Oumniaa/BHIKIRprojet_robot_pompier/code/Precision.md

Nous rappelons que notre projet est un robot pompier roulant sur des chenilles avec un bras robotique capable d'ouvrir des portes pour éviter les explosions de fumées aux soldats de feu, ainsi notre dépot est organisé comme suit :
 
 - Un fichier dédié au bras robotque contenant les 2 codes source faisant bouger le bras (servomotors).
 - Un fichier caméra.ino pour le fonctionnement du module cameraVga.
 - Un fichier moteur contenat la totalité des classes organisant la réception de la consigne (position) à travers les capteurs (laser,distance,module arduCam), le controles des moteurs (motor CC). ainsi qu'un fichier Jetson nano contenant la totalité des commandes utilisées.

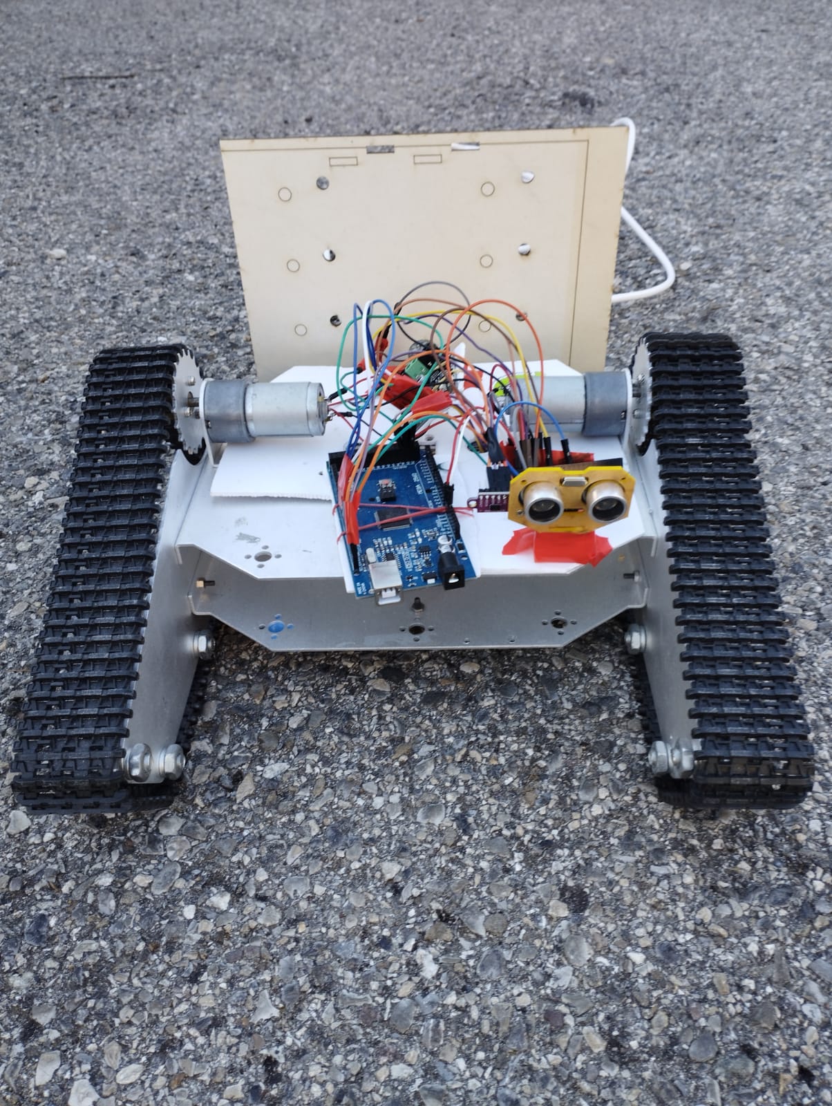
[picture p1: code/robot.jpg]
Photo Robot
  .

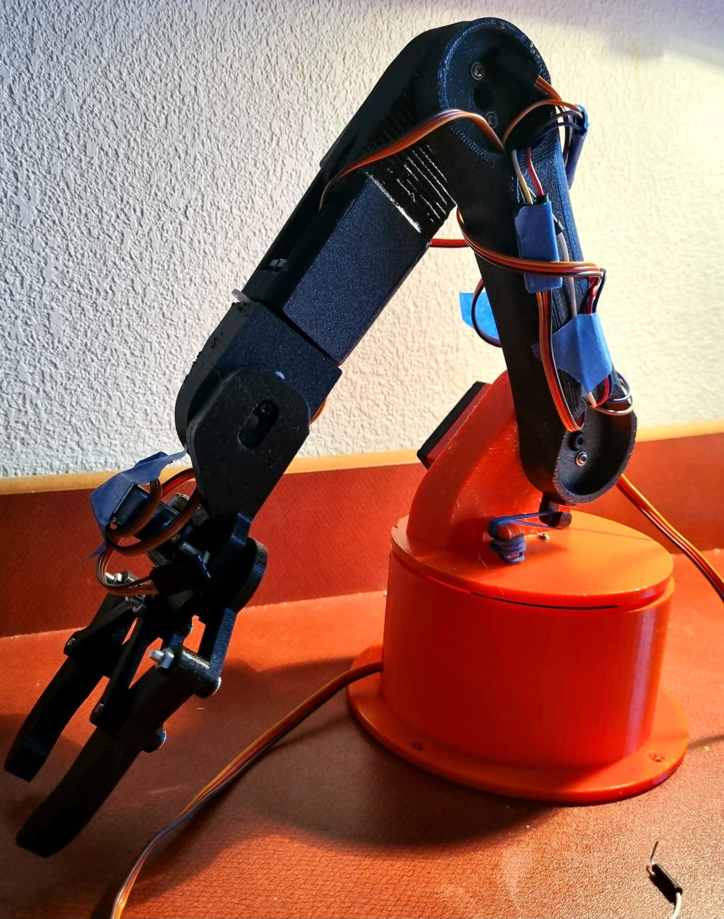
[picture p2: code/bras.jpg]
Photo bras
  .
