Oumniaa/BHIKIRprojet_robot_pompier/CompteRenduSeance/rio-rapport-seance-6.pdf

Guillaume RIO
Compte rendu 6ème séance
Comme nous avons dû rendre les cartes nvidia donc je vais durant cette séance réaliser une fonction afin d’éviter les obstacles.
Ensuite je vais coupler notre capteur de distance (ultrasons) avec un capteur de distance laser.
Je lui ai réalisé une classe dédiée.
Ensuite j’ai commencé à remplacer notre carte qui contrôle les moteurs par une nouvelle.

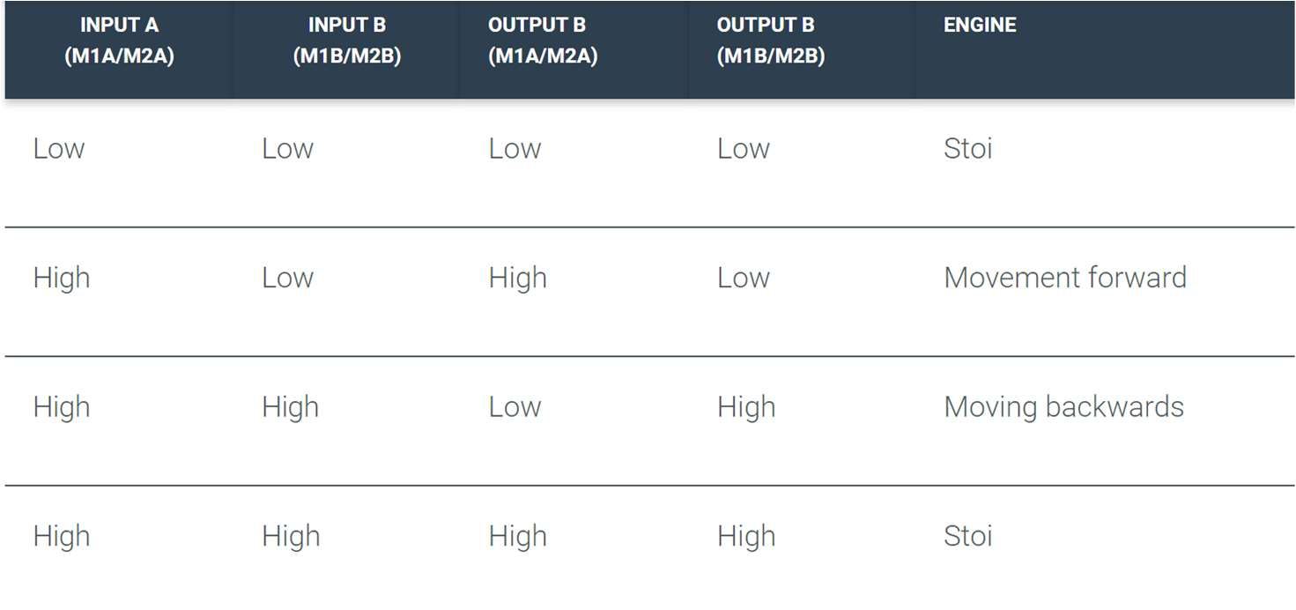
[picture p18: figure]

Donc après avoir réalisé les branchements, j’ai fait fonctionner les moteurs à la main (avec les boutons intégrés à la carte)
Puis j’ai fait fonctionner les moteurs avec un programme simple

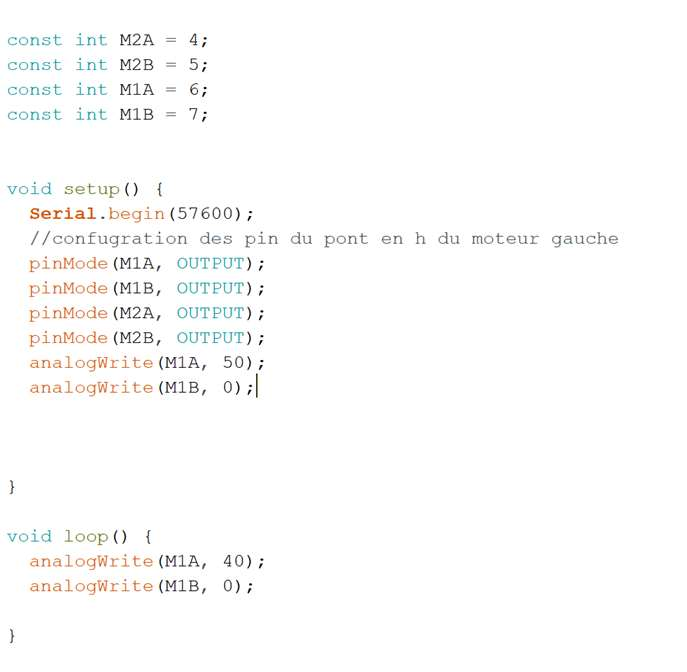
[picture p19: figure]

J’ai ensuite programmé une classe afin de gérer les moteurs avec ce nouveau controller. Afin de pouvoir avancer, reculer, tourner à droite, tourner à gauche (sur lui-même). Enfin j’ai découpé une plaque de plastique afin d’éviter les cours circuits lorsque les composants sont posés sur la plaque d’aluminium.
