Oumniaa/BHIKIRprojet_robot_pompier/CompteRenduSeance/rio-rapport-seance-3.pdf

RIO Guillaume

### Rapport séance 3

Tout d’abord, j’ai fait tourner les moteurs sans les controlers. En les alimentant directement.
Une fois cette étape réaliser j’ai récupéré un pont en h afin de pouvoir connecter et controller les deux moteurs. Une fois la connectique effectué, j’ai modifié ma structure moteur afin que chaque moteur est son pin de contrôle de la vitesse et les deux pin de contrôles du sens de rotation stocké.

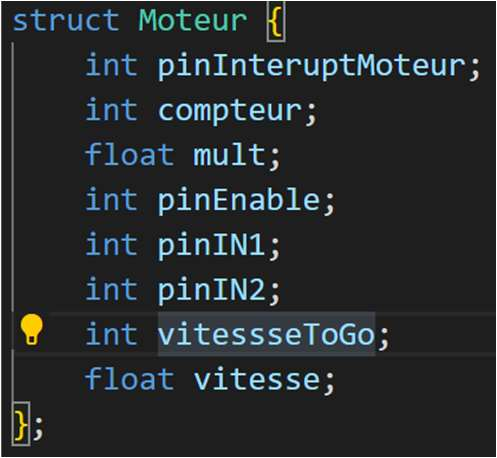
[picture p20: figure]

Ensuite, j’ai ajouté des fonction afin de controller le sens de rotation (avancer, reculer, tourner à gauche, tourner à droite)

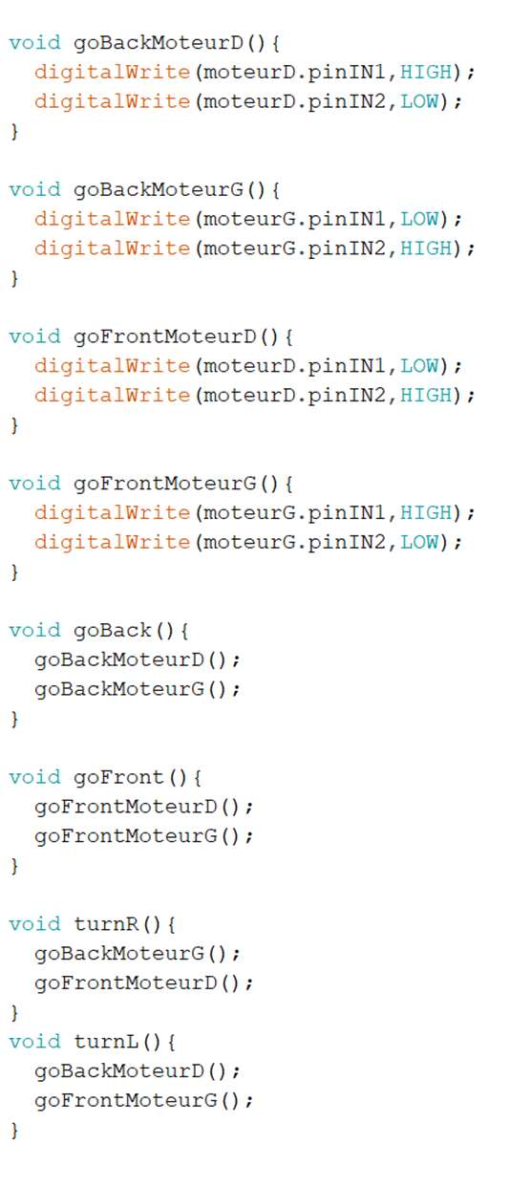
[picture p21: figure]

Ensuite, j’ai réaliser les fonctions afin de géré la vitesse. (stop et avancer)

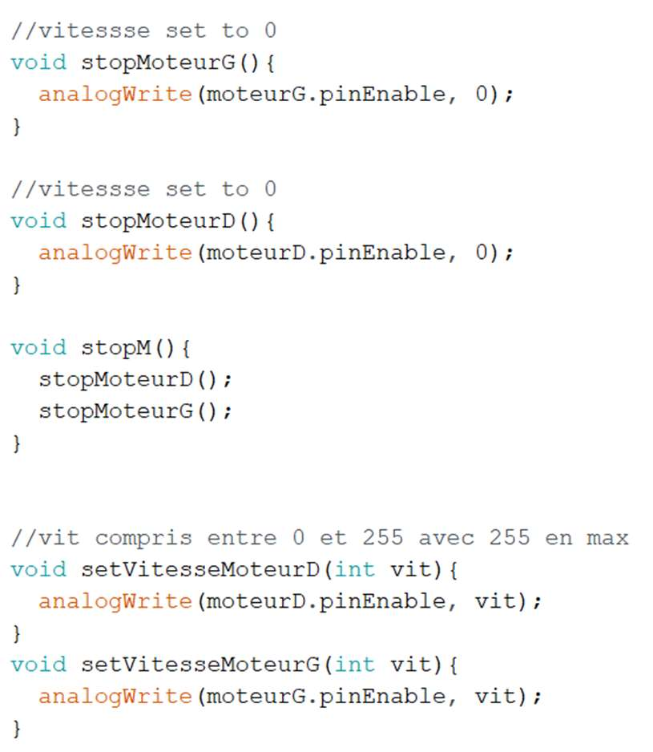
[picture p22: figure]

Enfin j’ai cablé le capteur de distance et j’ai inplémenté la classe du capteur de distance afin que le robot avance et lorsque le capteur de distance détecte un obstacle à moins de 10cm le robot s’arrète .

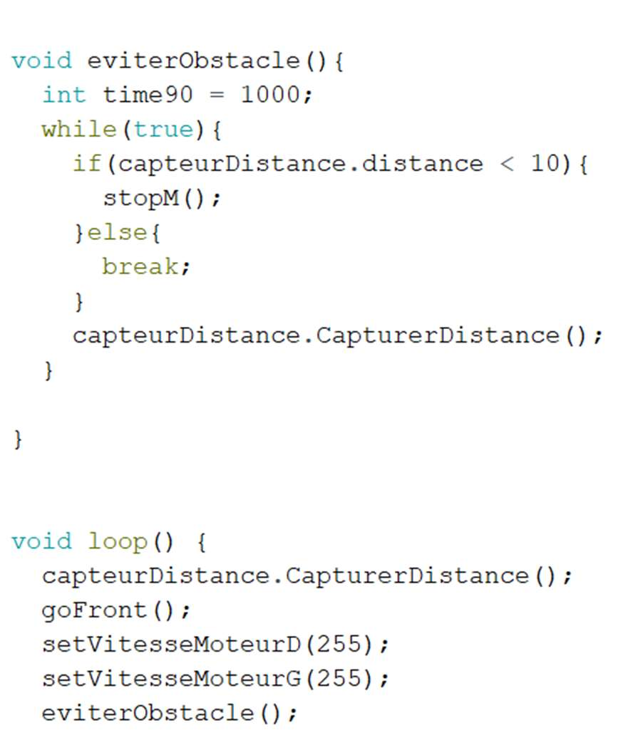
[picture p23: figure]
