Oumniaa/BHIKIRprojet_robot_pompier/CompteRenduSeance/rio-rapport-seance-2.pdf

RIO Guillaume

### Rapport séance 2

Mr Massons nous a été proposé de directement utiliser les chenilles d’un châssis d’un robot déjà constitué et avec des moteurs. Le problème est que les moteurs n’ont pas d’encoder permettant de récupérer notre vitesse. J’ai donc recherche s’il existe ce même moteur mais avec un encoder. Je n’ai rien trouvé de satisfaisant, je vais donc pour le moment ignorer cette manière de calculer la vitesse et on tentera de se débrouiller avec nos capteurs de distance et notre caméra.
J’avais comme première idée de faire une structure qui contiendra les paramètres de mon moteur et une classe de gestion des moteurs qui réalisera les fonctions lié au moteur. J’ai donc réaliser ceci : La structure :

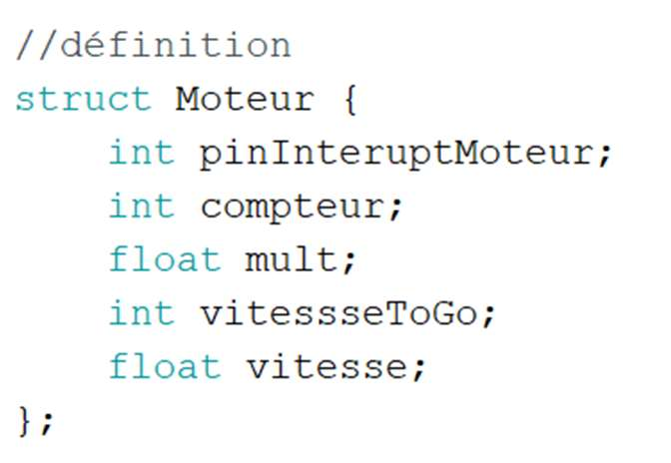
[picture p24: figure]

La classe :

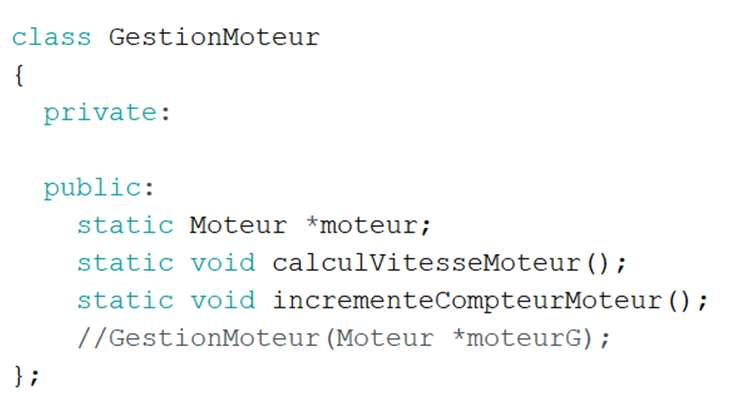
[picture p25: figure]

Les méthode et initialisation :

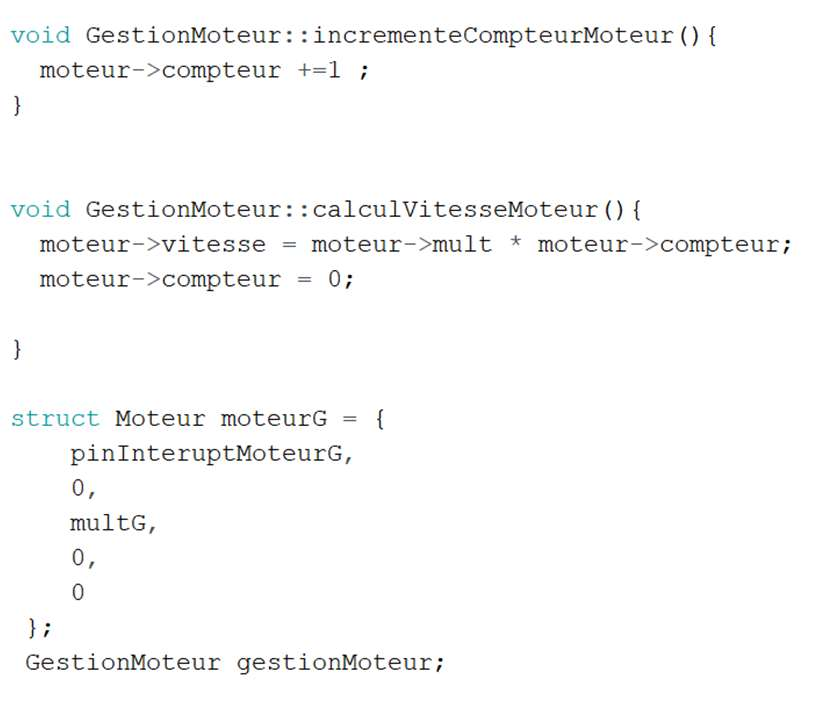
[picture p26: figure]
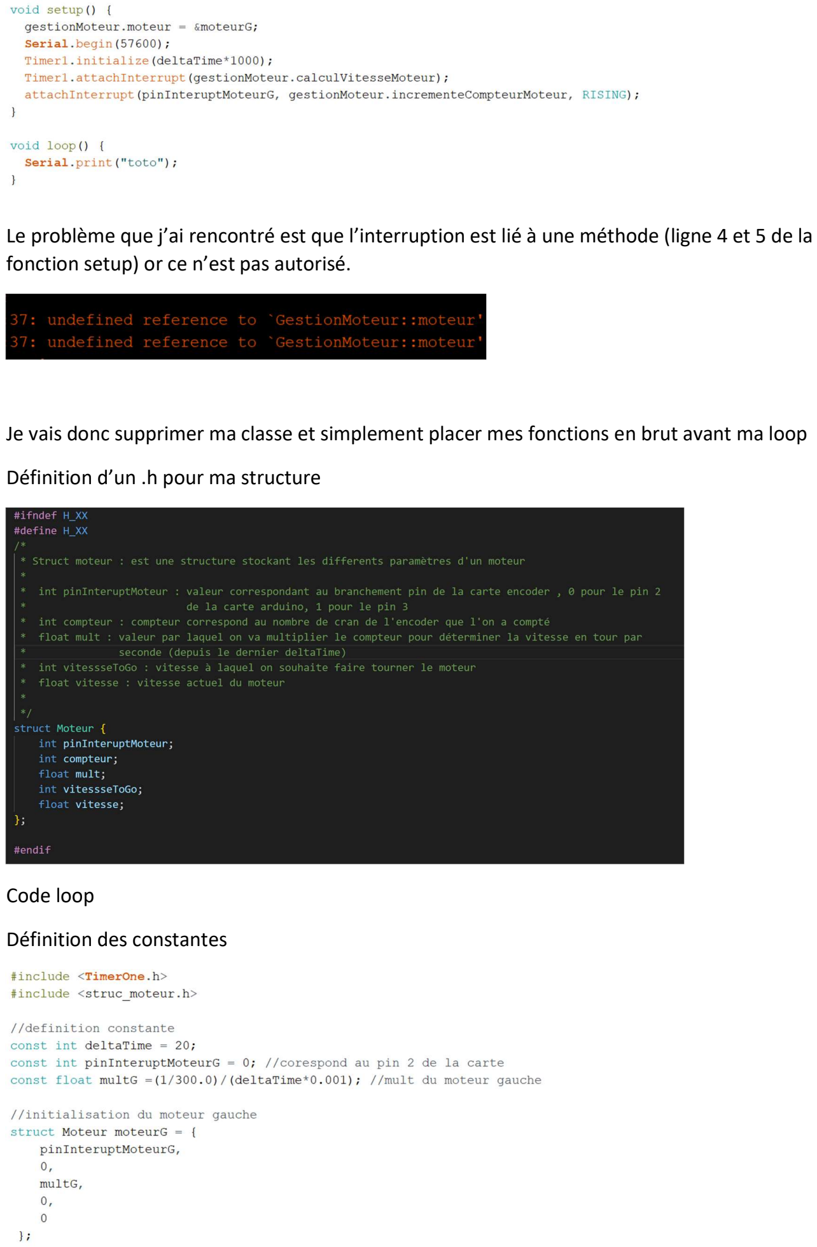
[picture p27: page 2]

Le problème que j’ai rencontré est que l’interruption est lié à une méthode (ligne 4 et 5 de la fonction setup) or ce n’est pas autorisé.

Je vais donc supprimer ma classe et simplement placer mes fonctions en brut avant ma loop Définition d’un .h pour ma structure

Code loop
Définition des constantes

Définition des fonctions pour les interruptions du moteur

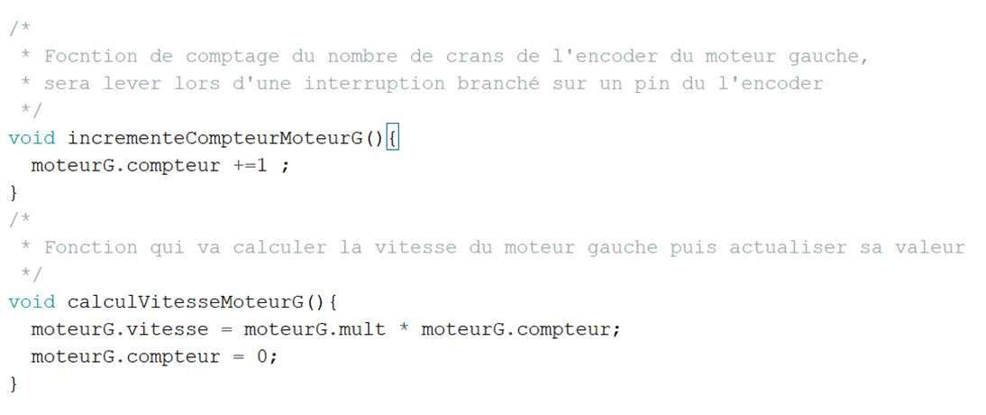
[picture p28: figure]

Définition du setup et loop

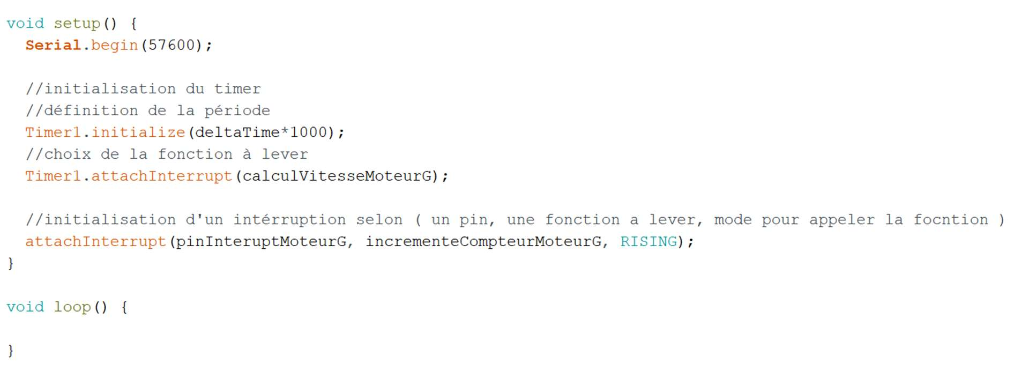
[picture p29: figure]
