Oumniaa/BHIKIRprojet_robot_pompier/CompteRenduSeance/Session 12-BHIKIR.pdf

Session 12

180° servomotors are now controlled with the PCA9685 module.

In order to be able to calculate the angles of movement of the arm from the known position of the object. We will use Al-Kashi's theorem (fig1), the position to be reached will correspond to the centre of the object that equal the centre of the arm gripper.

At first, we will simplify the case study to an arm with 2 mobile segments (we ignore the rotating base and the arm-clamp connection), then we will go to 3 segments and so on.

We retrieve the dimensions of the arm:

r1 = the humerus = piece connected to the first servomotor = 165 mm.

r2 = The ulna = piece connected to the second servomotor = 110 mm.

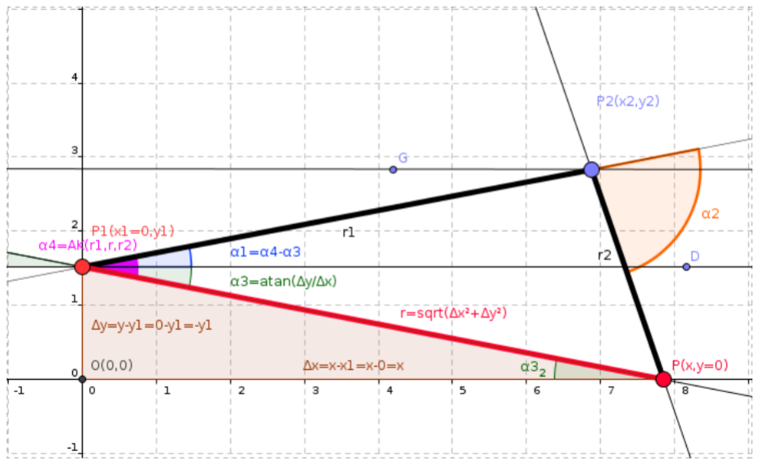
[picture p39: figure]

Fig 1: Al Kashi's theorem used to calculate the value of the 2 angles of the 2 servomotors of a 2-axis motorized arm.

The arm is positioned by giving (x, y) coordinate, and via what I understood from the concept of inverse kinematics [1], this is translated to the required servo angles.

The code is composed of two main functions:

1. Movearm (fig 2) responsible for the movement of the arm, we put the coordinates of the point to reach as a parameter then we calculate: angleE = alpha4 (fig1), angleS = alpha2.
2. MoveServo (fig 3) to adjust the measurements, since the Arduino has a margin of error.

The measurements are then transformed from radians to degrees.

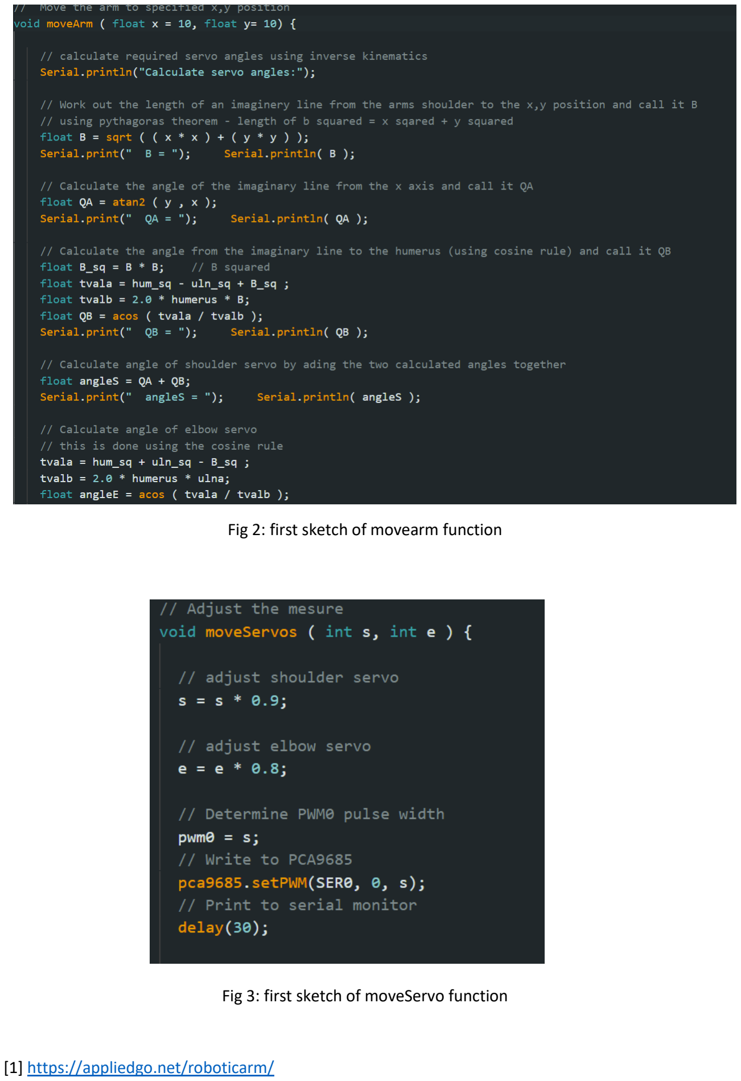
[picture p40: page 2]

Fig 2: first sketch of movearm function

Fig 3: first sketch of moveServo function

[1] https://appliedgo.net/roboticarm/
