Oumniaa/BHIKIRprojet_robot_pompier/CompteRenduSeance/Session 10-BHIKIR.pdf

Session 10

During this session, which served as a presentation of the end of the accomplishments during the 1st semester, I mounted the last missing part of the arm, the clamp. A model that I took from Grabcad – robot adaptive clamp- [1]. I then only modeled the arm-gripper connection.

This done, I mounted the parts together, and ensure that the 3 servomotors of the waist- and elbow base are powered at 6v with an external power supply and a DC DC converter while the other 3 servos are linked to 5V provided by the Arduino Uno.

The design part being finished (fig1), we now move on to the code.

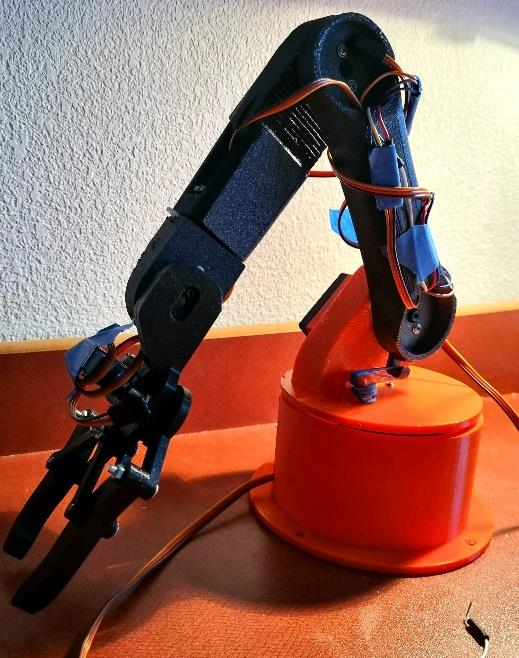
[picture p41: figure]

Fig 1: complete assembly of the robotic arm

First of all, the servos worked with potentiometers, one potentiometer per servo telling it the angle it has to go (fig2).

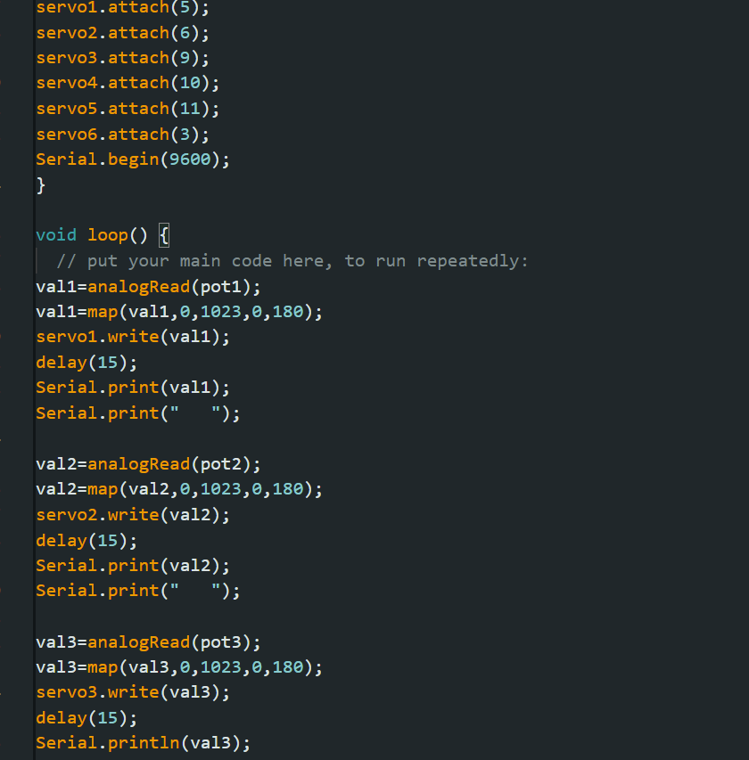
[picture p42: figure]

Fig 2: Knob code to control a servo with a potentiometer

The arm is now functional, I am now trying to order it with a Bluetooth module, first I establish the connection between the HC -05 module and my smartphone (fig 3) by following the technical sheet provided Go tonic [2]. However, two-way communication is not established, the transmission is successful, however I do not receive the reception message

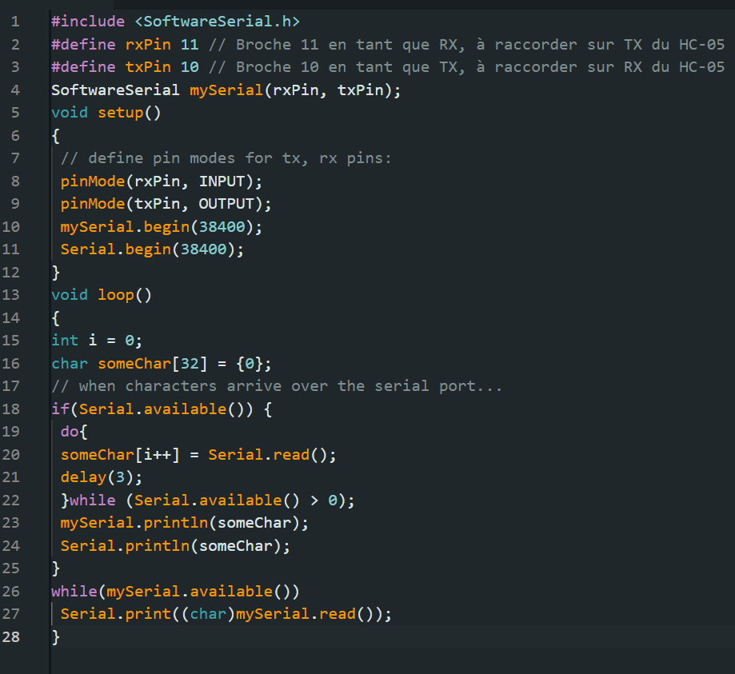
[picture p43: figure]

Fig 3: HC-05 / smartphone pairing code

[1] https://grabcad.com/library/tag/pince
[2] https://www.gotronic.fr/pj2-guide-de-mise-en-marche-du-module-bluetooth-hc-1546.pdf
