Oumniaa/BHIKIRprojet_robot_pompier/CompteRenduSeance/Session 9-BHIKIR.pdf

Session 9

I started by defining the list of handles that our arm can open crutch handle, button handle, L key handle.

Initially omits the pull handles which would require a torque exceeding that of our current servomotors as well as a backward movement.

Done, I start modeling the pliers by refining the tips to be able to grab the handle as well as possible, the impression will be launched at the next session.

In parallel, to set up an optimized code, I continue by defining the limits of movement of my angles, the mapping of the motors produced, I resume writing the code.

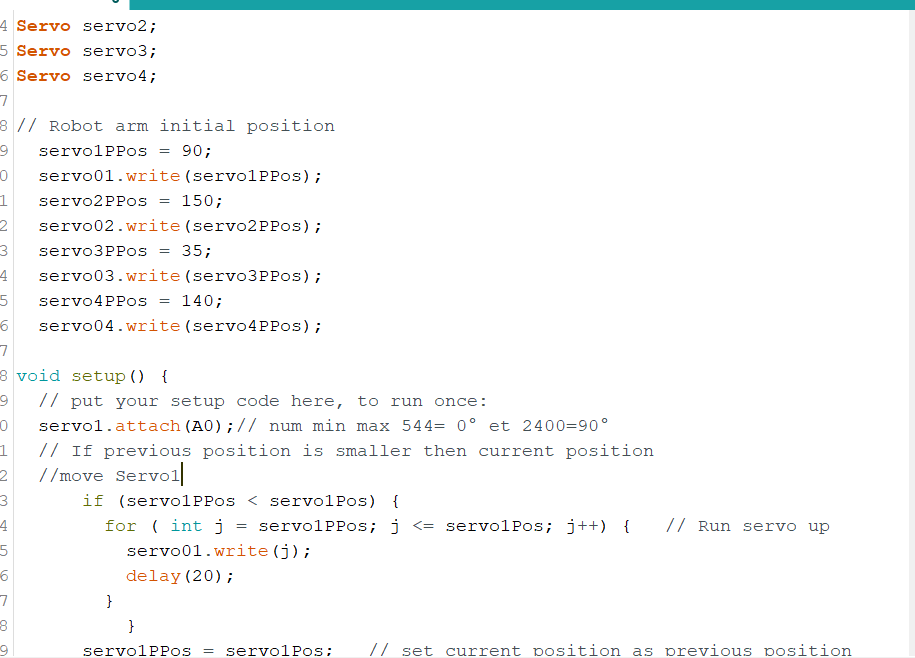
[picture p46: figure]

Fig 1s Code’s sketch

First, the code will be written without class then test to debug then a Servomotors class will be defined with functions like: StartMotor, RotateRight, RotateLeft …

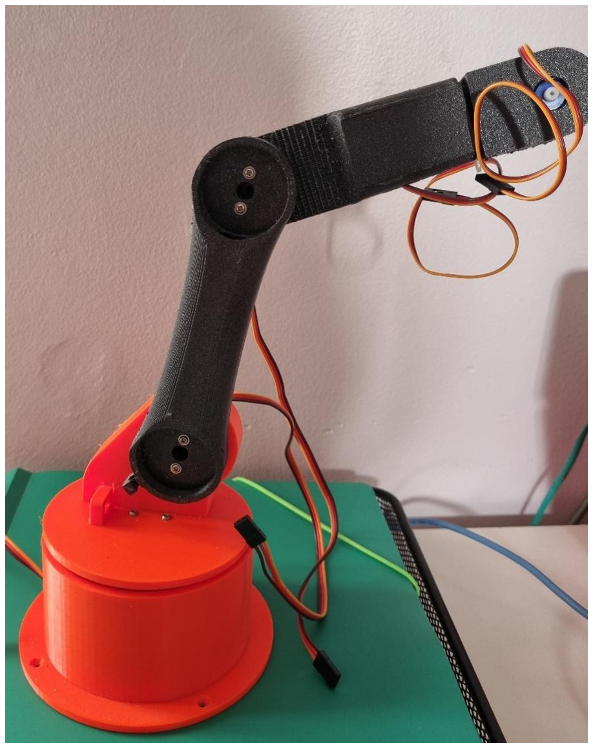
[picture p47: figure]

Fig 2 : First arm look
