Oumniaa/BHIKIRprojet_robot_pompier/CompteRenduSeance/Session 5-BHIKIR.pdf

Session 5

During this session I tried to give the robot its final look.

I started by dismantling the tank to recover the pair of tracks. thing done I materialized the wooden plates leaving spaces to integrate the motors and a certain number of holes to target the digital cards.

the laser cutter broke down during the first hour I resumed my work on the robotic arm, unfortunately the base of my arm is 20 cm in diameter the plate of the Prusa printer is 15cm which pushes me to reduce the size of my base and risk impacting the stability of my arm or printing on the volumic.

I opt for the second option in a first place at the risk of having to resize everything. In the meantime, the 2 servomotors acquired during the previous sessions are functional (the class is finalized), their real effectiveness will be measured during their integration into the arm.

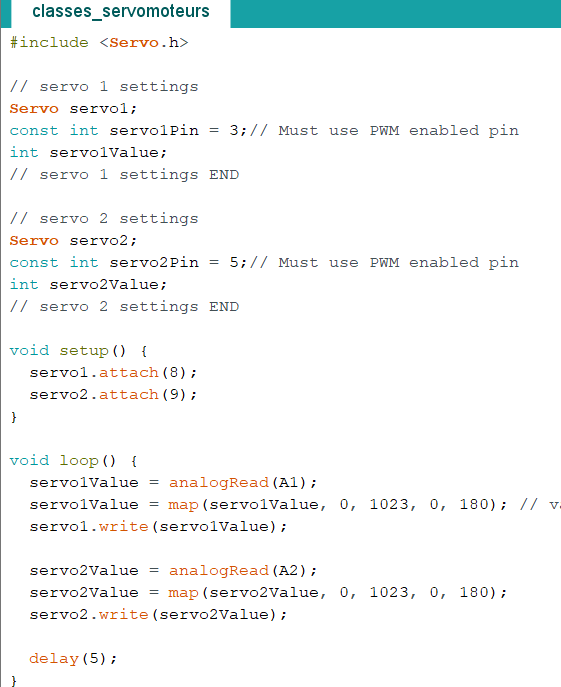
[picture p53: figure]

the laser cutter finally functional with plywood I cut the first boards (lower and side) by binding them with a wedge. the result is functional but gives an effect "tinkered not clean". So not satisfied I direct my choice towards a parametric box with notches that can be linked without wedges (to be glued potentially).

The raw model is available on boxes.py : https://www.festi.info/boxes.py/UniversalBox?language=fras

I have already determined the entry of the DC motors and the location of the screws; they just have to add them now on insckape.
