Oumniaa/BHIKIRprojet_robot_pompier/CompteRenduSeance/Session 1 ang.pdf

### Session 1

1. Chassis and hull design.

The first part of the session was dedicated to the search for the crawlers that best suited the structure of the imagined robot, after many counting, we decided to start on the model Trex 355*265*130 mm, which allowed to obtain a certain exploitable volume.

The track system will be recovered and we will inject our own DC motor.

https://www.gotronic.fr/art-chassis-a-chenilles-t-rex-21385.htm

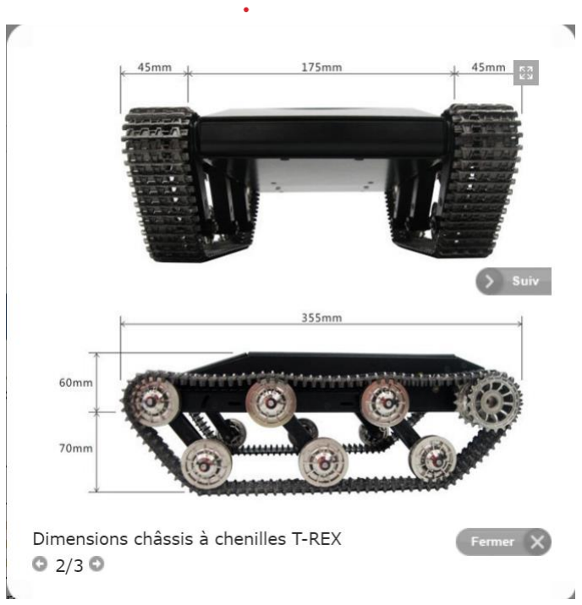
[picture p61: figure]

Once the measurement were established, the first sketch of the hull was made.

It was necessary to determine the most optimal location of the components inside the hull (a wooden cube 175*350*70), the rest of the height is left to the retractable arm.

2. Arrangement of the components within the shell.

The 6 wooden boards will be connected by screwed gaps otherwise the ventilation nestled on the back will be neglected at first.

- Top board: the arm will be connected to the rest of the structure by a circular system of 8 holes.
- Back board: the battery whose mass estimated at 70g will be glued to the middle of the rear board.
- Front board: a 3mm plexiglass plate will be plated to the front board, through this plate the camera supported by a modeled support to create the next session, the ultrasound sensor and infrared detector will be able to work.

- Bottom board: will contain the rest of the electronic components (accelerometer/gyroscope/Arduino board screwed in the middle, Nvidia card connected initially to the camera) by adding holes to connect all the actuators and electronics, which will be glued with hot glue or tape).

Once all the components delivered, we will make sure of the measurements again before cutting the frame in the final material ( wood ).

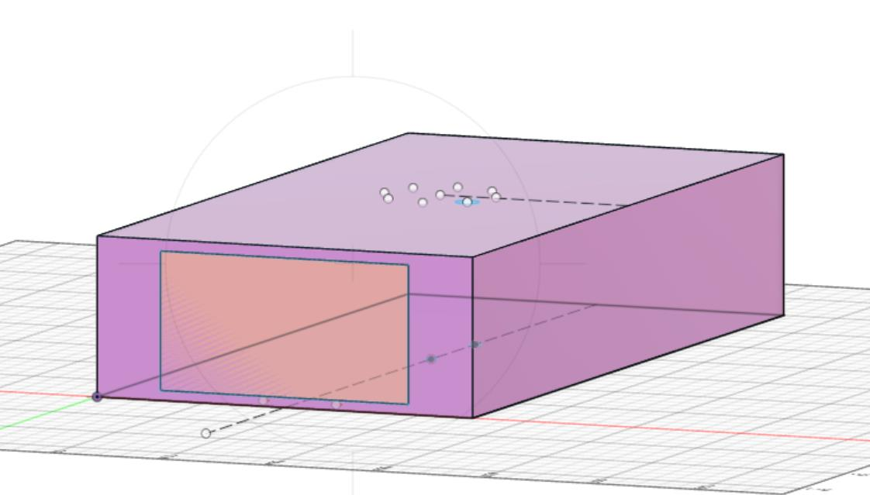
[picture p62: figure]

Once the chassis / shell part is finished, I’ve been interested in operating the HC-SR04 ultrasound sensor that will be glued to the bottom board back of the plexiglass plate.

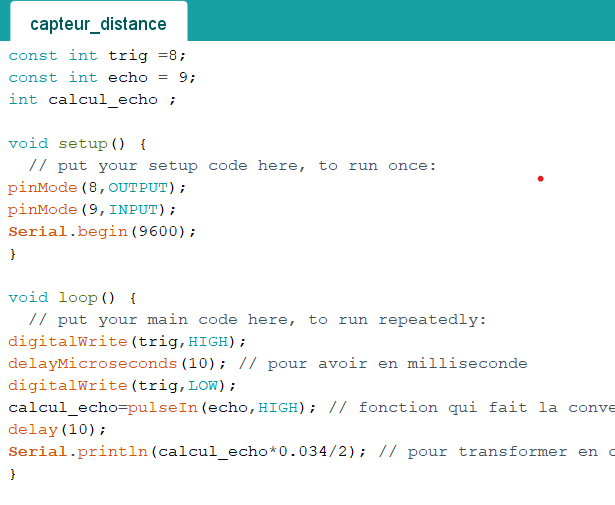
[picture p63: figure]

Well, the sensor works, I can now define a SensorDistance class that can be called anytime during the program to display the speed.

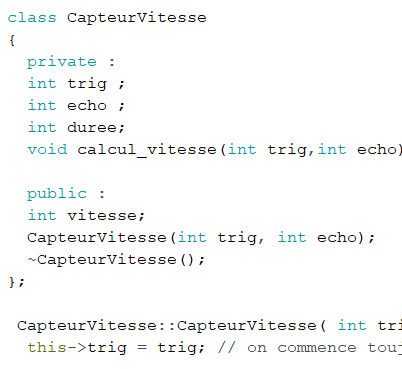
[picture p64: figure]
