Oumniaa/BHIKIRprojet_robot_pompier/CompteRenduSeance/rio-rapport-seance-21.pdf

Guillaume RIO
Compte rendu 21ème séance
- Fixage mécanique des composants du robot
- Réalisation du câble managent
- Réalisation de test sur le bras
