Oumniaa/BHIKIRprojet_robot_pompier/CompteRenduSeance/rio-rapport-seance-20.pdf

Guillaume RIO
Compte rendu 20ème séance
- Corriger des problèmes de rotation du robot
- Ajout d’une nouvelle couche pour la détection de la porte (avec la couleur)
- Aide à oumnia la détection de la poigné
- Réalisation de test sur le robot
