Oumniaa/BHIKIRprojet_robot_pompier/CompteRenduSeance/rio-rapport-seance-18.pdf

Guillaume RIO
Compte rendu 18ème séance
- Bombé la porte en orange pour mieux la reconnaitre dans l’environnement
- Optimisation de la stratégie pour aller vers la porte
- Explication à Oumnia comment faire de la détection d’image
- Fixation du bras sur le robot
