Oumniaa/BHIKIRprojet_robot_pompier/CompteRenduSeance/rio-rapport-seance-15.pdf

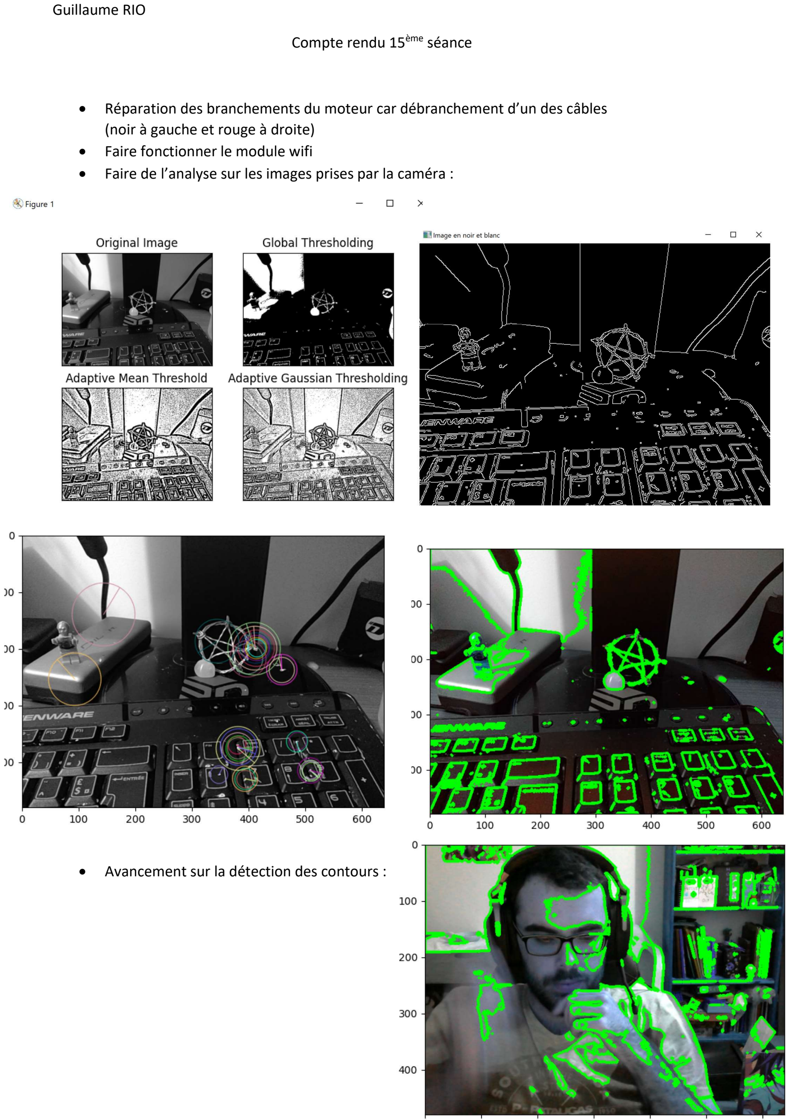
[picture p65: page 1]

Guillaume RIO
Compte rendu 15ème séance
- Réparation des branchements du moteur car débranchement d’un des câbles (noir à gauche et rouge à droite)
- Faire fonctionner le module wifi
- Faire de l’analyse sur les images prises par la caméra :

T

- Avancement sur la détection des contours :

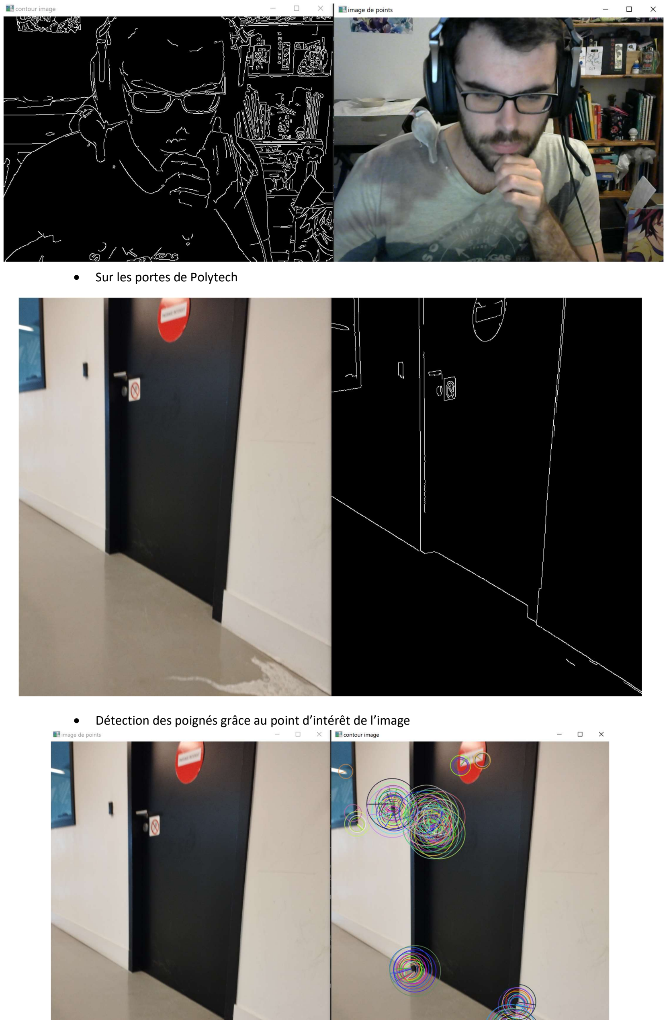
[picture p66: page 2]

- Sur les portes de Polytech
- Détection des poignés grâce au point d’intérêt de l’image

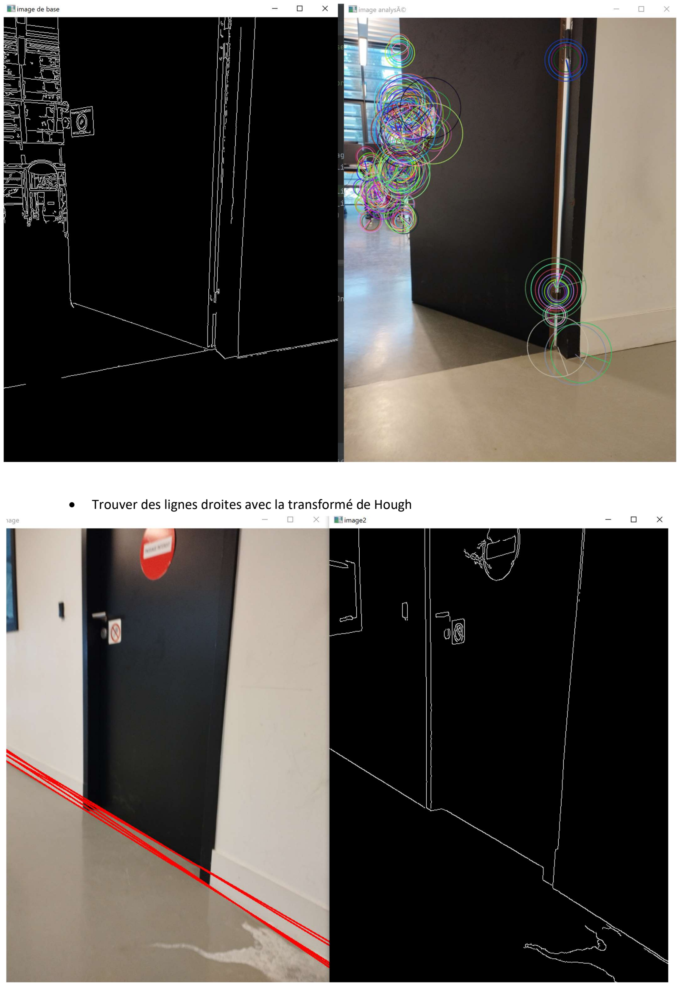
[picture p67: page 3]

- Trouver des lignes droites avec la transformé de Hough

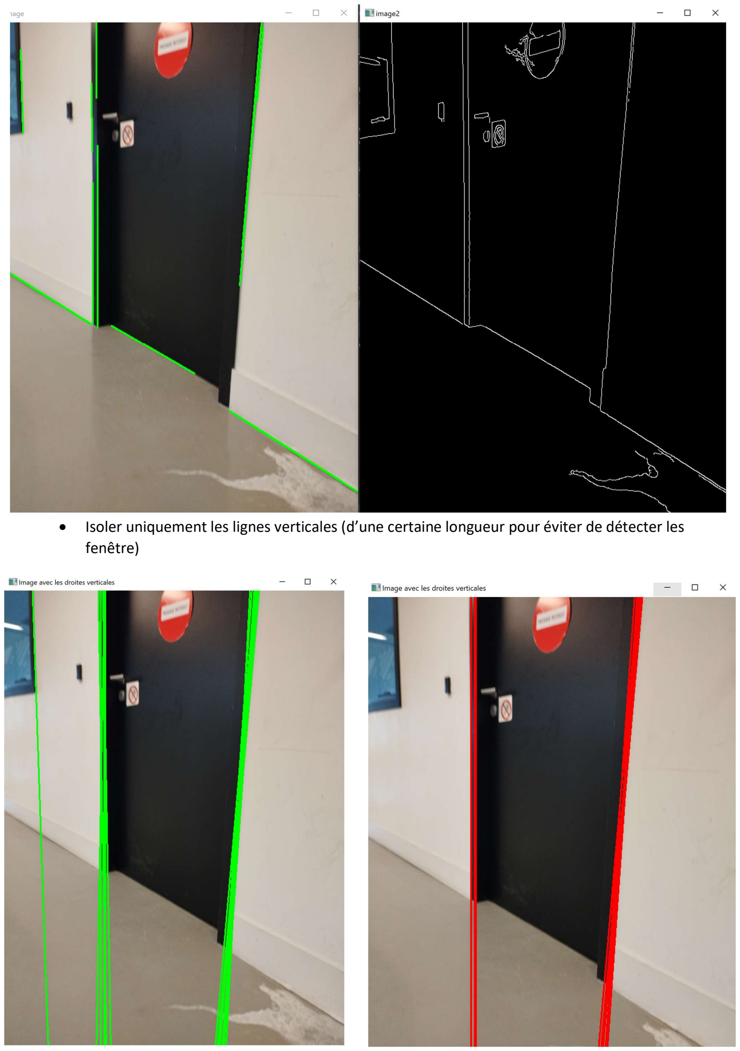
[picture p68: page 4]

- Isoler uniquement les lignes verticales (d’une certaine longueur pour éviter de détecter les fenêtre)

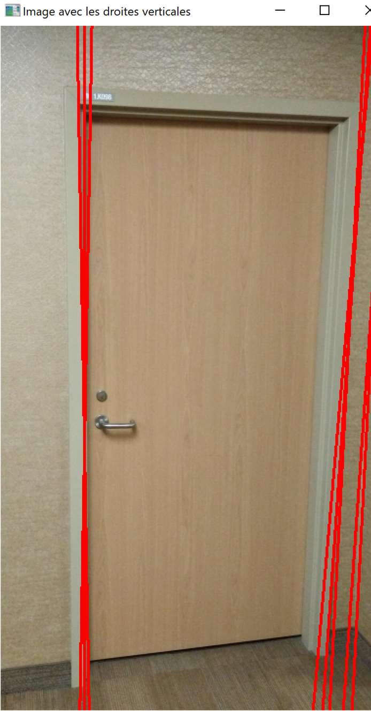
[picture p69: figure]
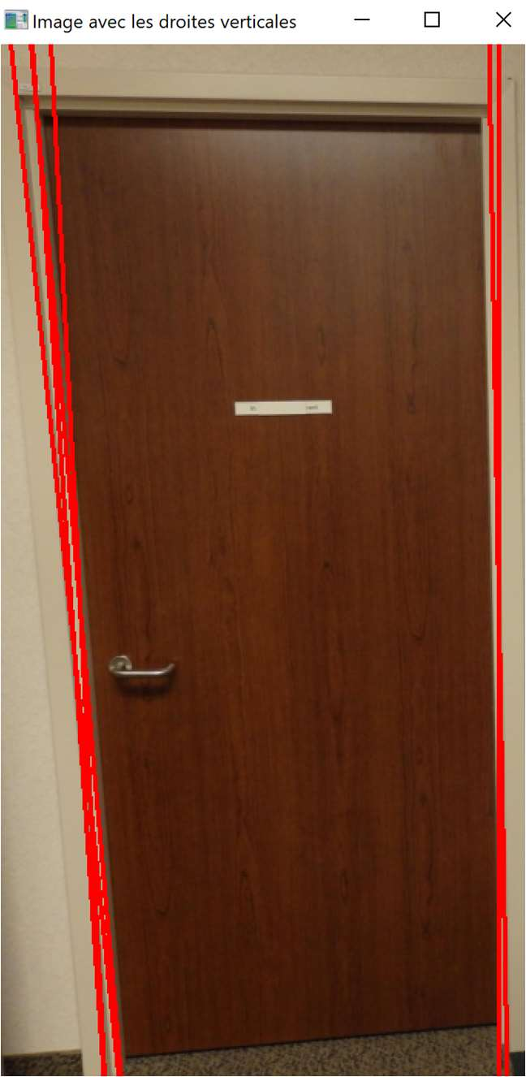
[picture p70: figure]

- Fabrication de la porte que l’on devra ouvrir
- Test d’ouverture par poussé avec le robot
