Oumniaa/BHIKIRprojet_robot_pompier/CompteRenduSeance/rio-rapport-seance-14.pdf

Guillaume RIO
Compte rendu 14ème séance
- Faire des tests sur l’IA entrainé sur 50 epoch
o J’ai observé que l’IA pensait que toute les images étaient des portes o J’ai donc ajouté des données au dossier nonPorte
- Utilisation de la caméra sur la carte
- Prise d’une photo et sauvegarde
- Utilisation de l’IA sur les images sauvegardées pour déterminer si on est fasse à une porte

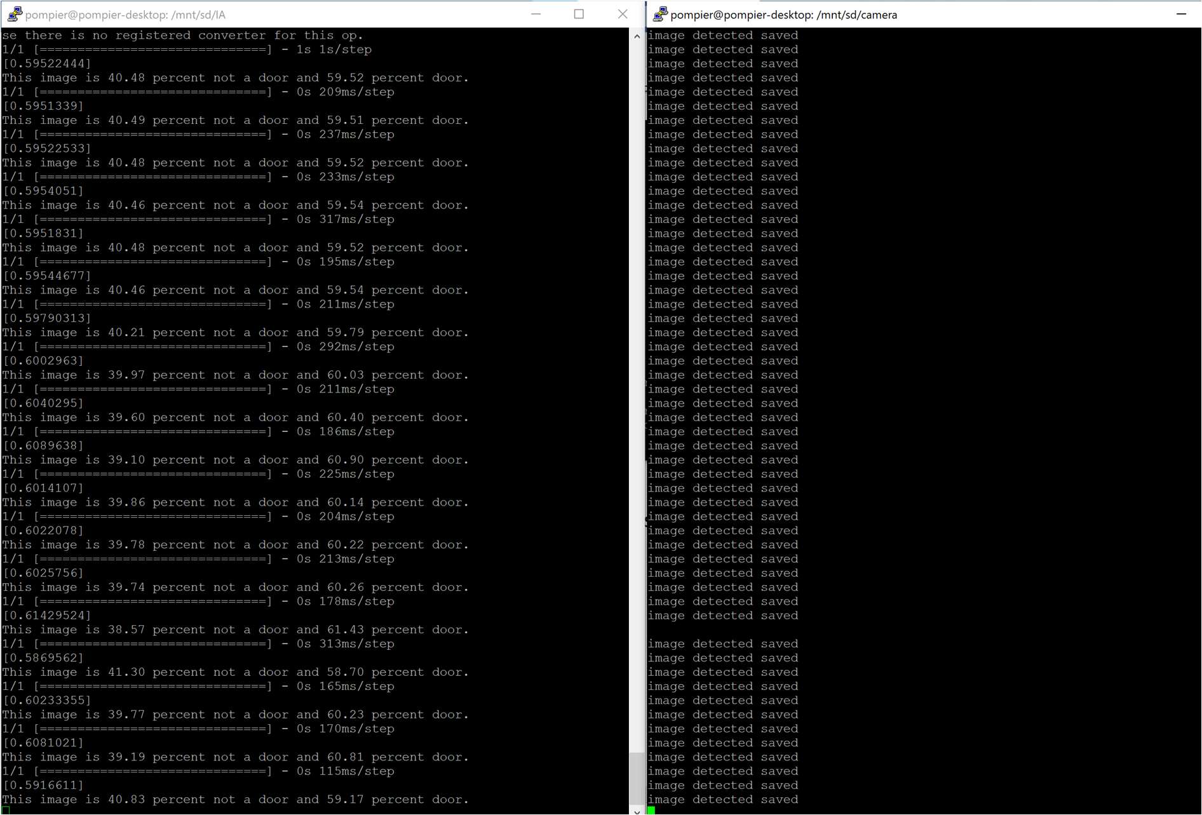
[picture p71: figure]

- Enfin j’ai commencé à lire de la documentation sur le module wifi
