Oumniaa/BHIKIRprojet_robot_pompier/CompteRenduSeance/rio-rapport-seance-12.pdf

Guillaume RIO
Compte rendu 12ème séance
- Sur mon IA qui commence à reconnaitre des portes :
o J’ai tout d’abord ajouté une fonctionnalité permettant de sauvegarder et de charger mon IA
o Problème d’installation de python sur la carte Nvidia, j’ai donc corrigé le problème
o Ensuite j’ai lancé des entrainements :

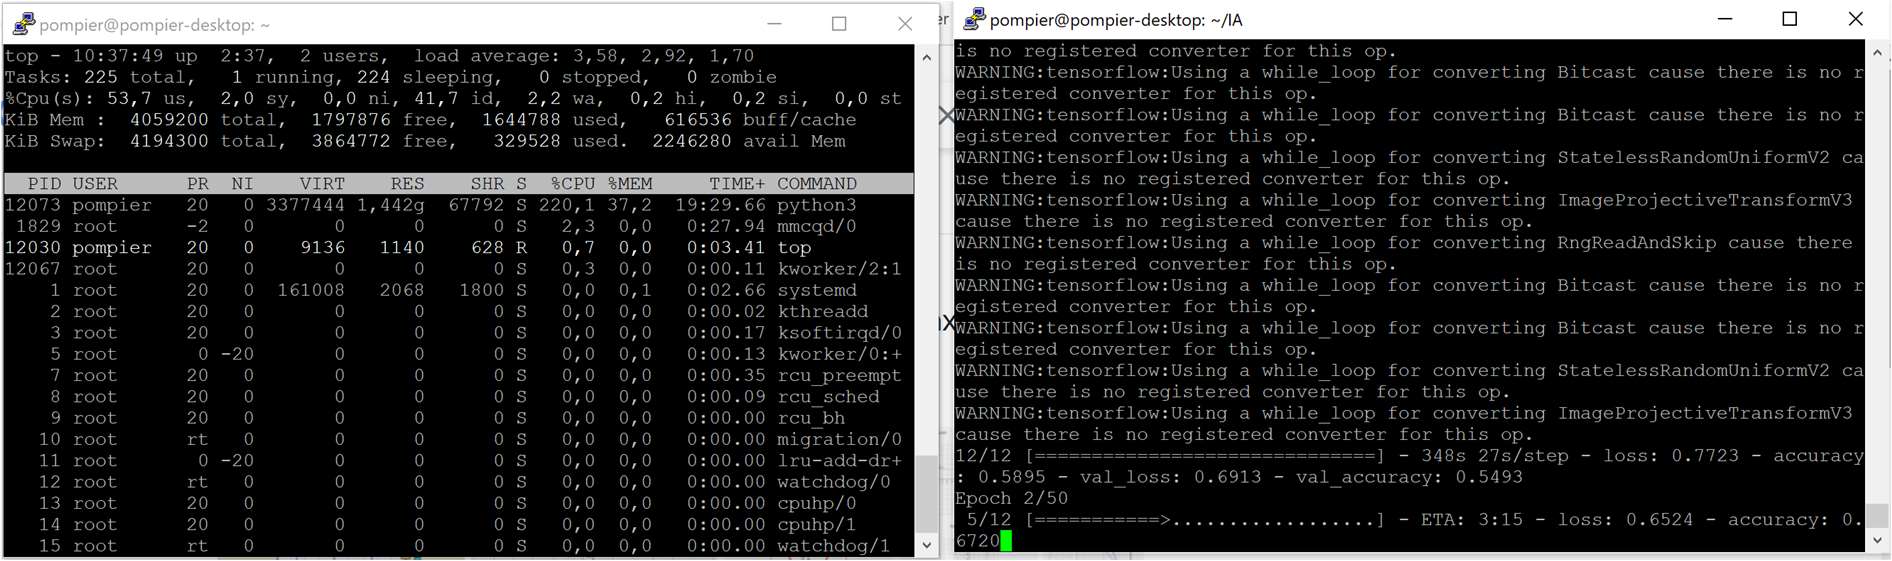
[picture p72: figure]

o Ensuite j’ai aidé Eva pour essayer d’avoir un truc fonctionnel
