Oumniaa/BHIKIRprojet_robot_pompier/CompteRenduSeance/rio-rapport-seance-11.pdf

Guillaume RIO
Compte rendu 11ème séance
- Recherche d’une base de données de porte
- Téléchargement de 4000 images puis je les ai triées une à une dans différents dossier (porte
(2) / escalier (0) / autre (1) )
- Réalisation d’une IA avec Keras sur le jeu de données téléchargées
o 1 : Suppression des données mal encodées.
o 2 : Génération des données d'entrainement et de validation o 3 : Afficher les images de la base de données créé

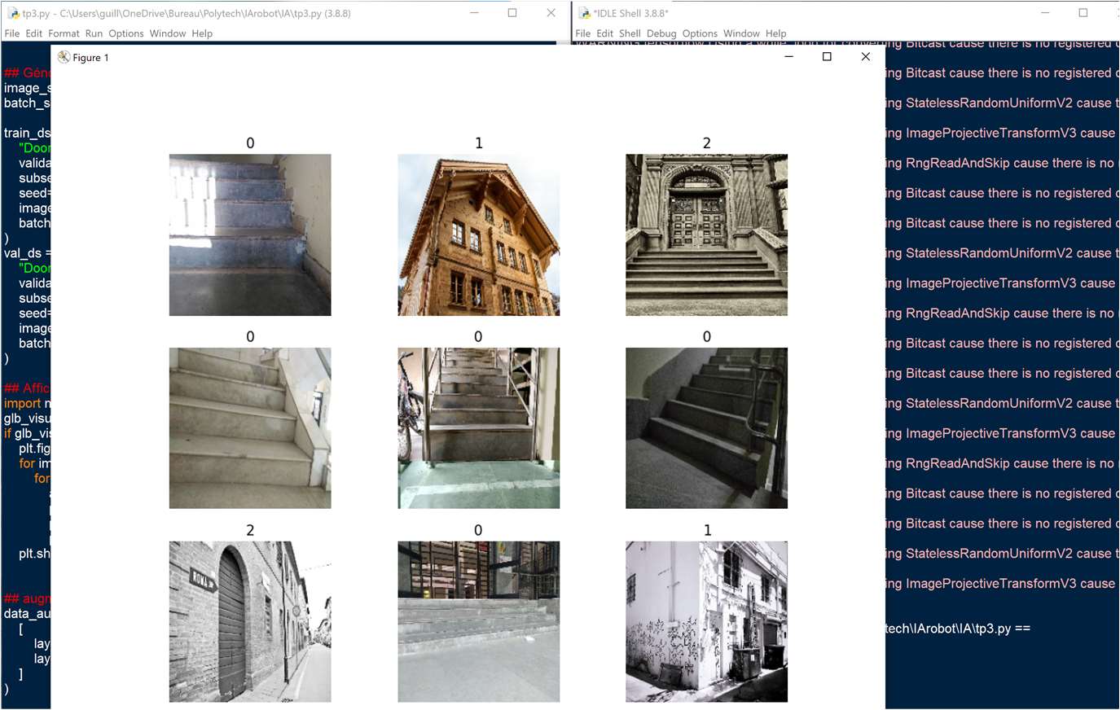
[picture p73: figure]

o 4 : Augmentées les données (rotation, miroir, ect..)
o 5 : Afficher les images de la base de données augmentées

o

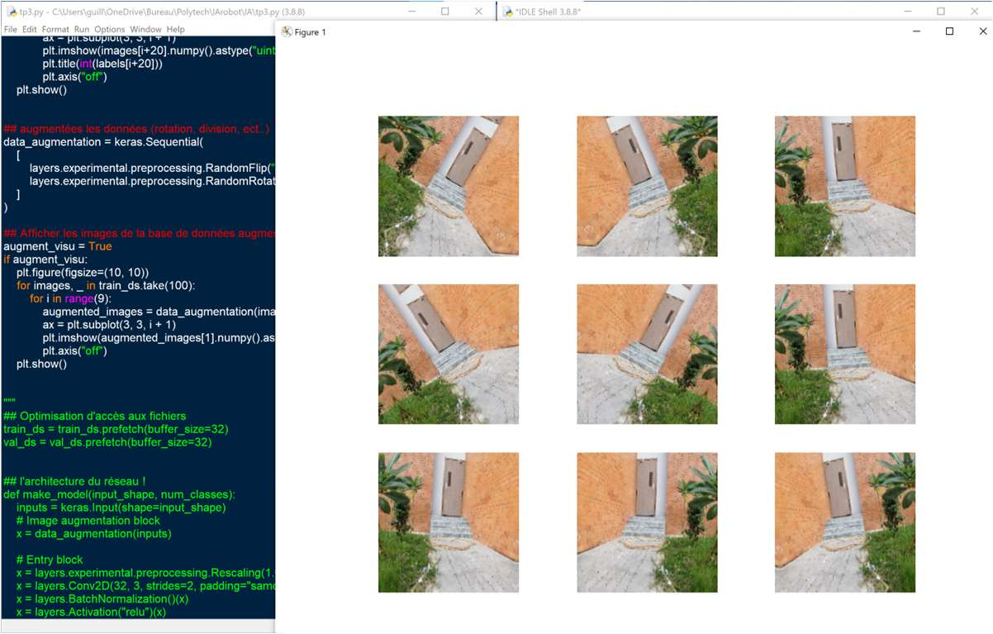
[picture p74: figure]

o 6 : entrainer l’IA mais malheureusement avec mon PC (la carte étant avec Oumnia) je n’arrive pas à l’entrainer ( mon pc manque de calcul )

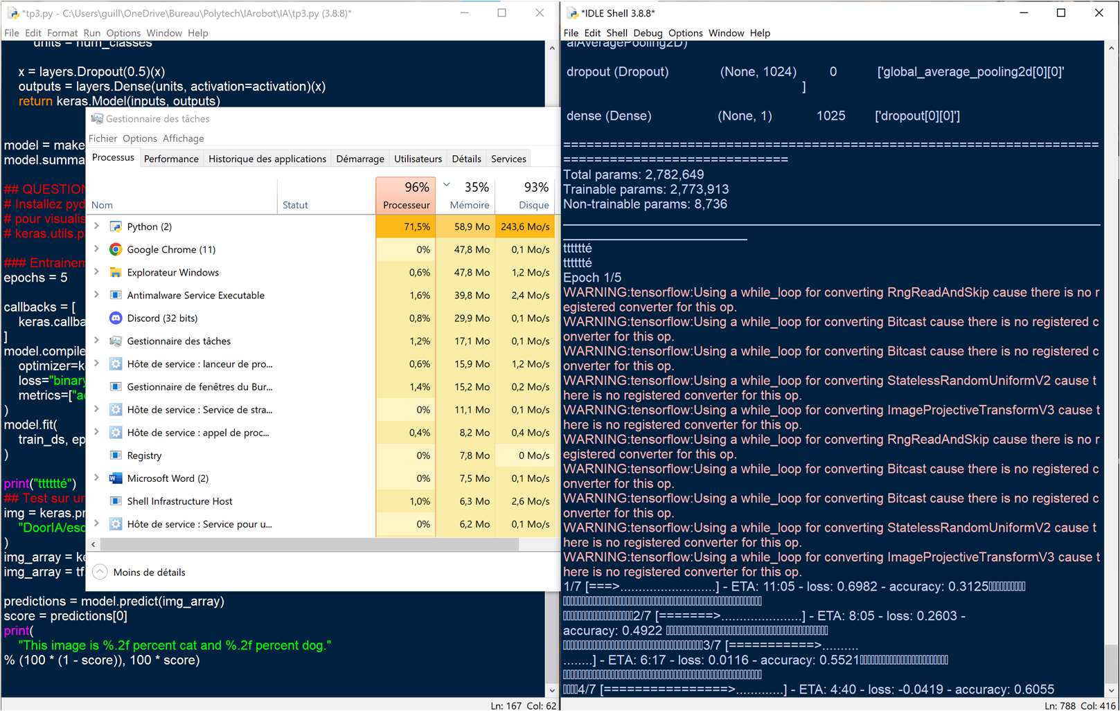
[picture p75: figure]
