Oumniaa/BHIKIRprojet_robot_pompier/CompteRenduSeance/rio-rapport-seance-5.pdf

Guillaume RIO
Compte rendu 5ème séance
Tout d’abord j’ai intégré le programme de la caméra de souris et la led rouge avec les programmes précédents (les moteurs et les capteurs de distance). Ainsi, maintenant lorsque le robot se déplace on possède une position approximative depuis son départ. (Seulement en X et Y et il peut y avoir des perturbations si notre robot monte ou décent une pente)

Ensuite, je me suis connecté en série à la carte nviadia jetson nano à l’aide de putty.

J’ai installé un conteneur docker afin de pouvoir utiliser JupyterLab

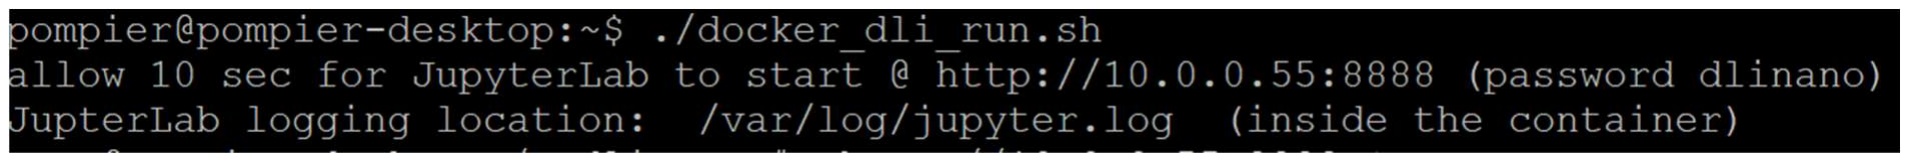
[picture p76: figure]

En utilisant jupiter pour coder, j’ai fait fonctionner la caméra en mode photo et vidéo.

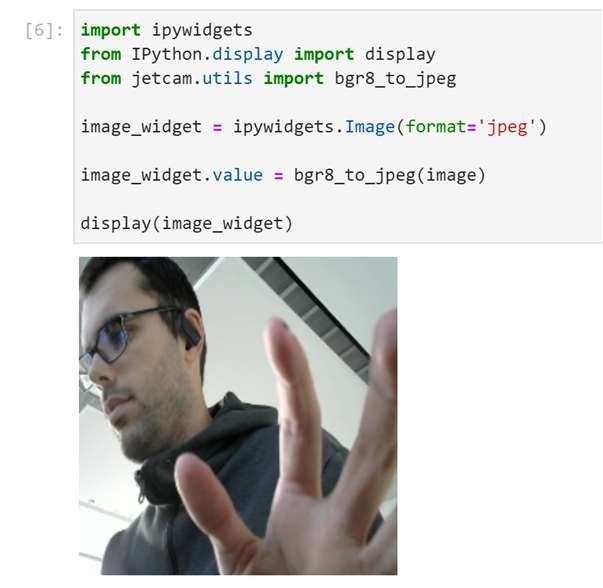
[picture p77: figure]

Ensuite je voulais commencer à réaliser de l’intelligence artificiel mais je n’ai pas réussi à installer Torch, je possède ce message d’erreur lors de l’importation.

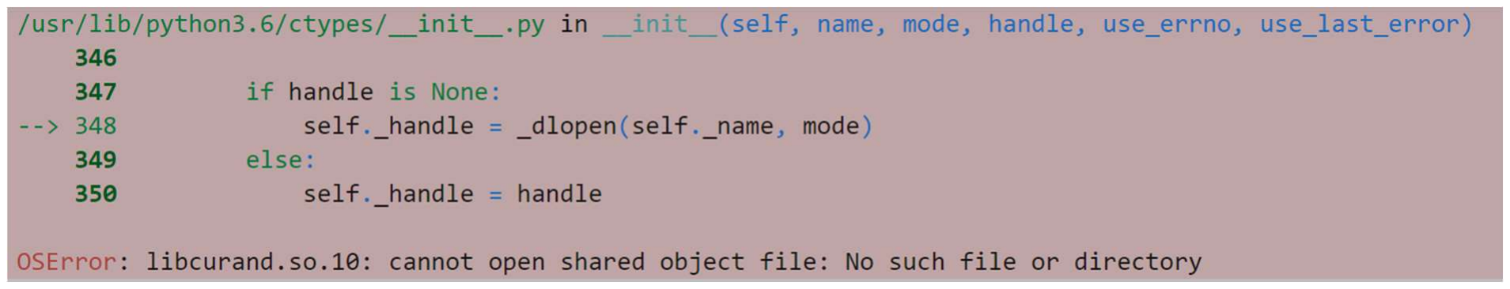
[picture p78: figure]

Il y a surement un conflit entre les versions de cuda torch et python, je tenterai de résoudre ce problème lors de la prochaine séance.
