Oumniaa/BHIKIRprojet_robot_pompier/CompteRenduSeance/rio-rapport-seance-4.pdf

Guillaume RIO
Compte rendu 4ème séance
Dans un premier temps j’ai tenté de résoudre un problème pour me connecter à la carte nvidia. Je ne comprends pas pourquoi l’adresse ip de la carte et modifié par mon ordinateur ( j’arrive à me connecter à la carte avec mon ordinateur fixe)

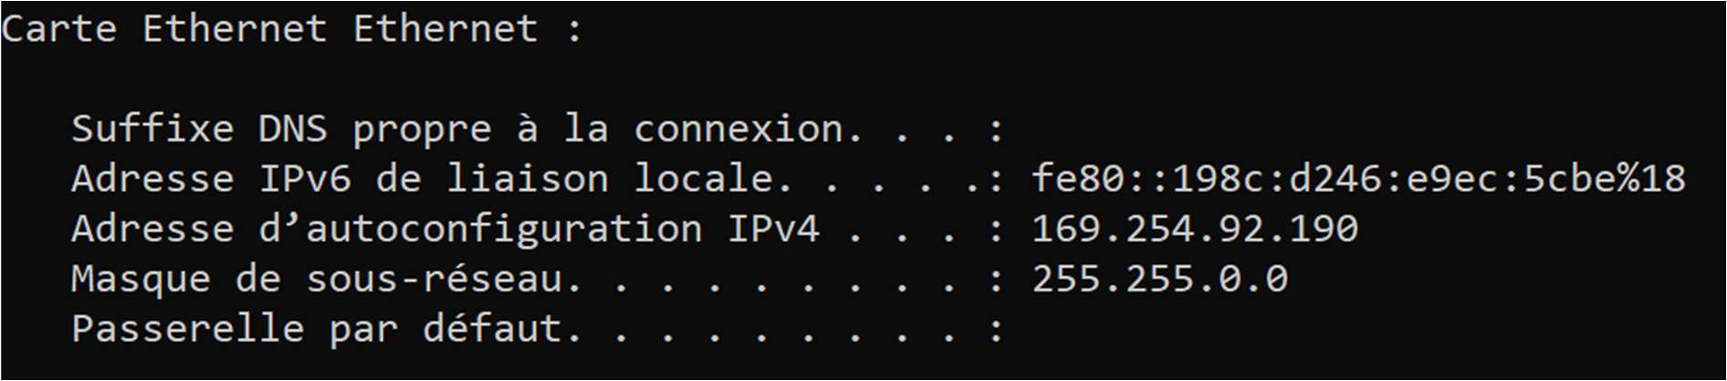
[picture p79: figure]

Puis

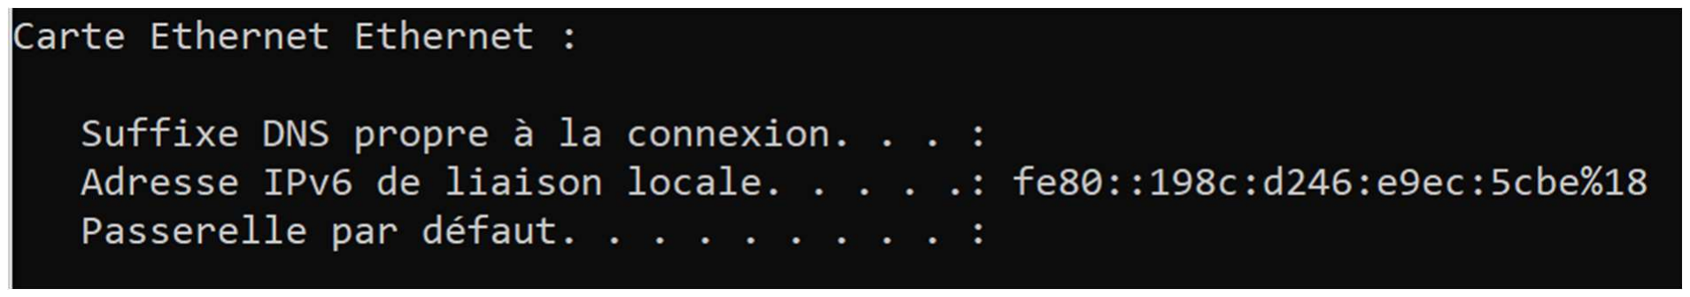
[picture p80: figure]

Puis

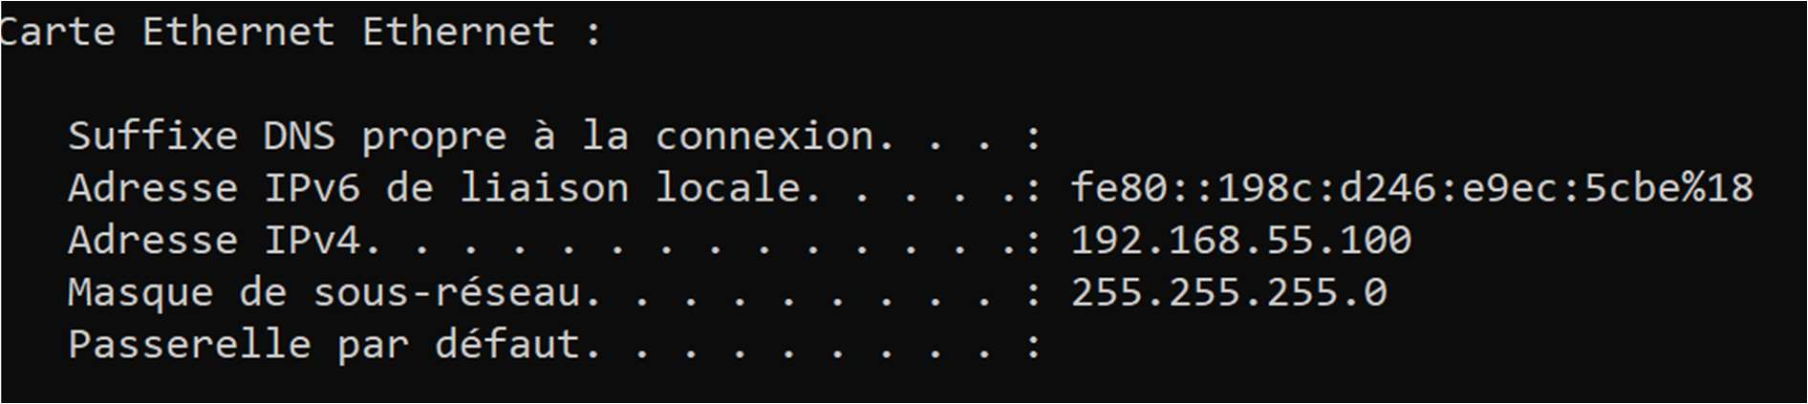
[picture p81: figure]

N’arrivant pas à résoudre le problème j’ai fait fonctionné la caméra de souris afin de récupérer la position en x et y de notre robot, puis j’ai réalisé une classe afin de pouvoir gérer proprement ma caméra.
De plus, la caméra ne fonctionne pas très bien à courte distance selon la couleur de l’objet observé. Nous allons donc utiliser une led rouge afin d’éclairer le sol.
