Oumniaa/BHIKIRprojet_robot_pompier/CompteRenduSeance/rio-rapport-seance-1.pdf

RIO Guillaume

### Rapport séance 1

Durant cette séance, j’ai dû choisir un moteur. J’ai eu le choix entre un moteur déjà présent sur un robot à chenille et autre proposé par Mr Masson. Je suis donc aller chercher les datasheet des deux moteurs pour les comparer.
Moteur du robot à chenille :

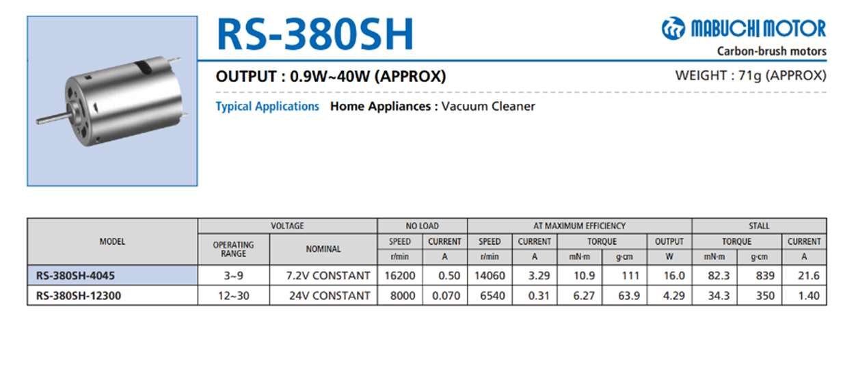
[picture p82: figure]

DT-25 moteur proposé

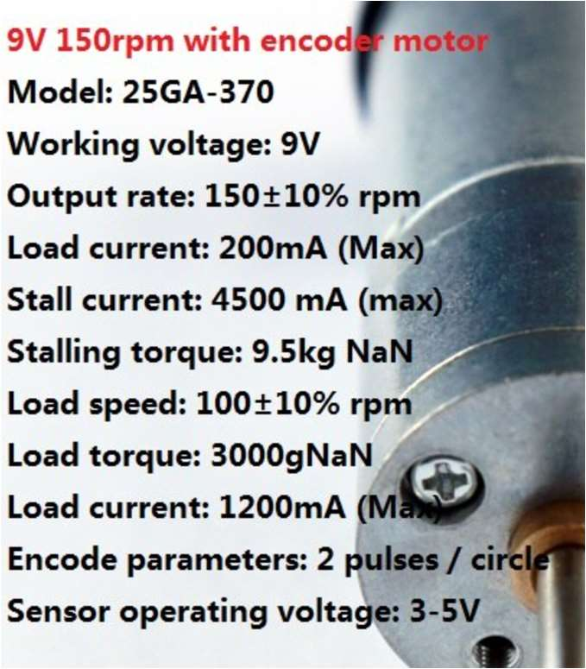
[picture p83: figure]

On a décidé que le moteur proposé était satisfaisant. J’ai donc commencé par faire tourner le moteur.
Ensuite, il fallait calculer la vitesse du moteur. Pour ce faire, à l’aide d’une interruption compter le nombre de tour du moteur en un certain temps. Pour ce moteur, 1 tour complet du moteur correspond à 300 impulsions du capteur

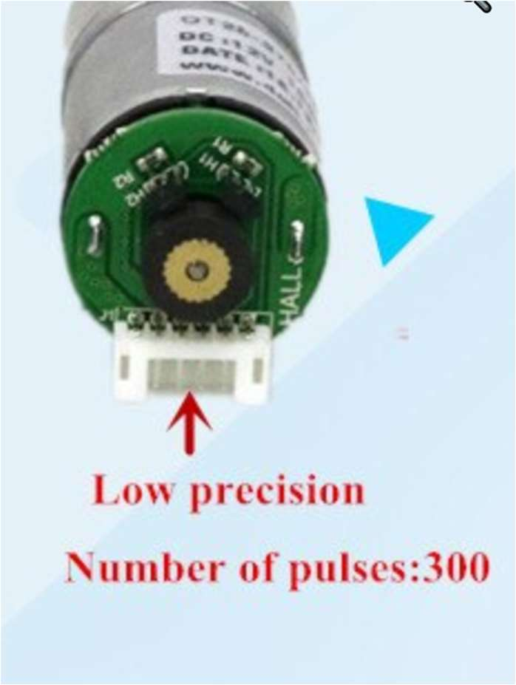
[picture p84: figure]

J’ai donc compté les impulsions dans le code :

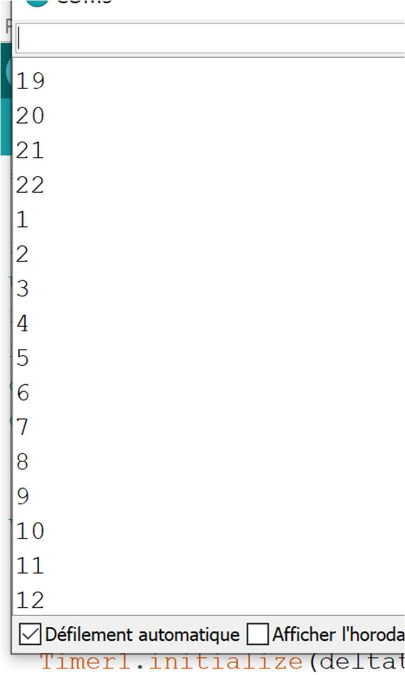
[picture p85: figure]

Pour enfin réaliser le calcul qui me donne la vitesse en tr/s.

Ensuite, j’ai décidé de réaliser une classe pour notre moteur.

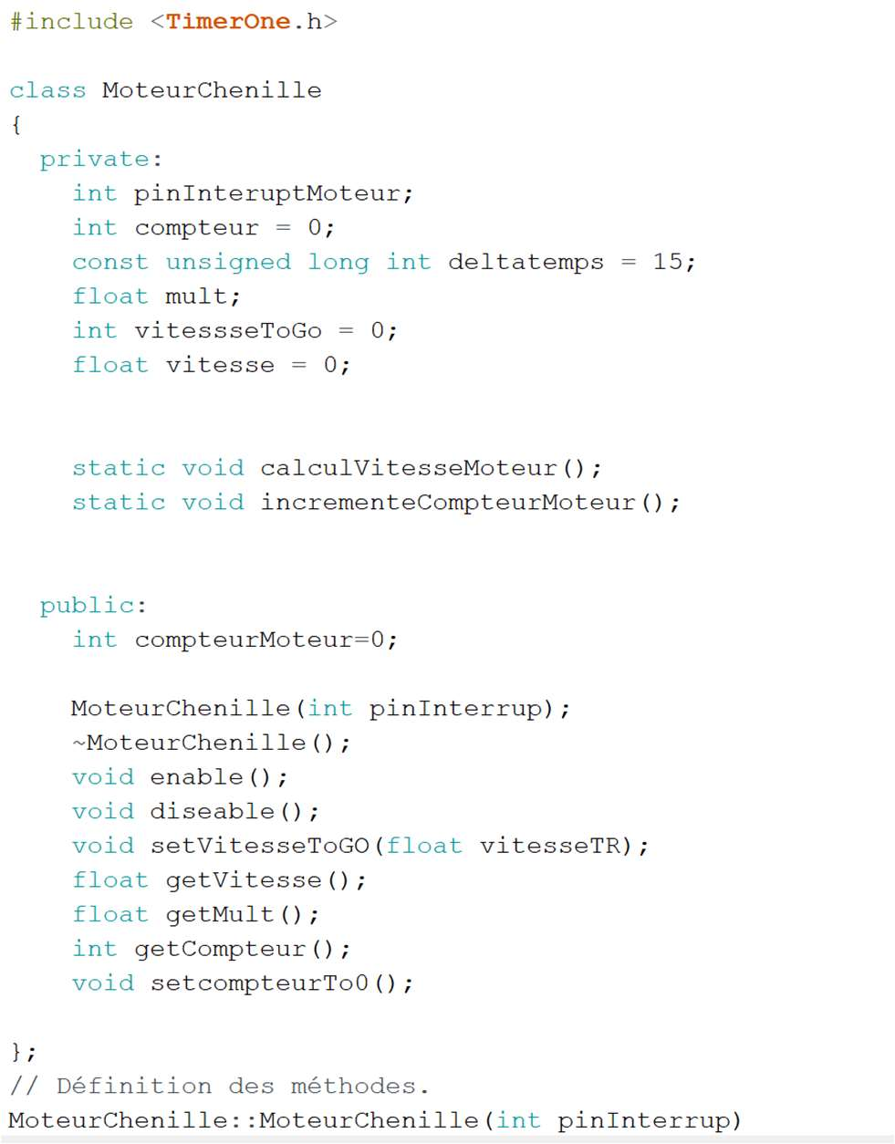
[picture p86: figure]
