Oumniaa/BHIKIRprojet_robot_pompier/Boitier arduino/Projet_arduino_BHIKIR_Oumnia.3mf

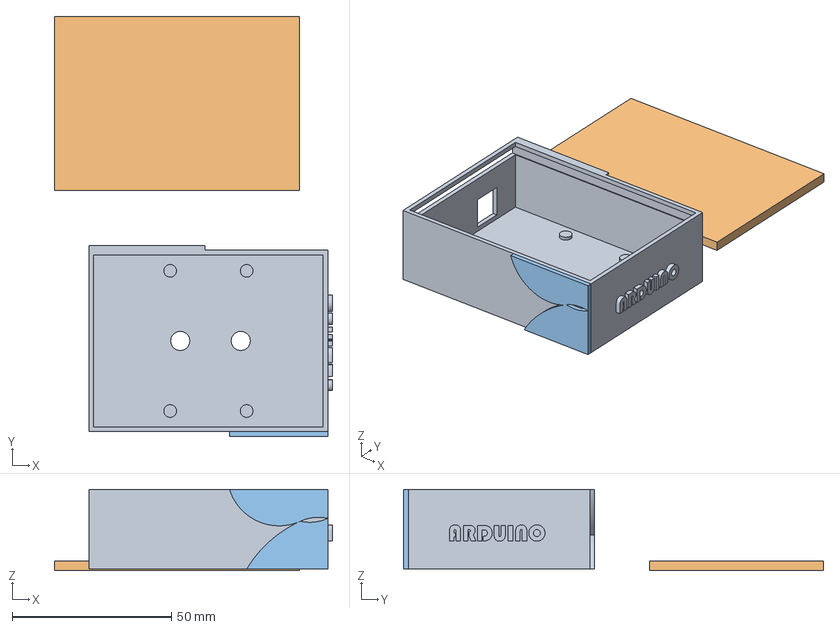
[picture p89: CAD file, 2022-11-15]
Boitier arduino/Projet_arduino_BHIKIR_Oumnia.3mf
87.4 x 131.8 x 25.5 mm
Corps1 x 2
Corps2
