Oumniaa/BHIKIRprojet_robot_pompier/Boitier arduino/boiteCarteArduinoRIO.3mf

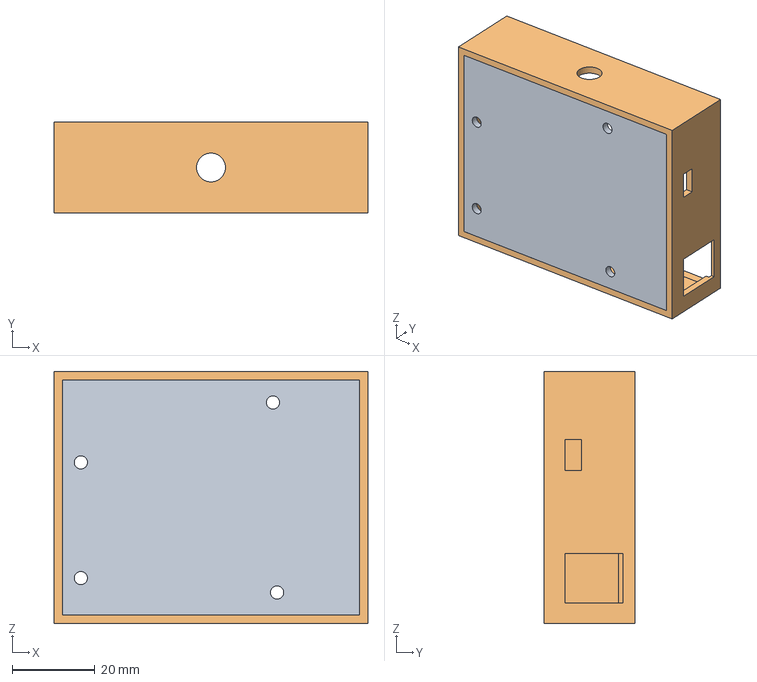
[picture p90: CAD file, 2022-11-15]
Boitier arduino/boiteCarteArduinoRIO.3mf
76.0 x 22.0 x 61.0 mm
Corps1
Corps2
