Oumniaa/BHIKIRprojet_robot_pompier/(list of files, cad)

Other CAD files:
Boitier arduino/Projet_arduino_BHIKIR_Oumnia.f3d
Boitier arduino/boiteCarteArduinoRIO.f3d
