Oumniaa/BHIKIRprojet_robot_pompier/projet_morse/BHIKIR-Oumnia_morse/LettreMorse/LettreMorse.ino

#include "LettreMorse.h"

LettreMorse lm;               // on definit un objet lm appartenant à la classe LettreMorse.

String mCode = "ie";        // Mot à traduire.
int timer = 200;             // Vitesse de période d'affichage en ms, à modifier selon le besoin.


void setup() {
  Serial.begin(9600);    // Baudrate.
  pinMode(LED_BUILTIN, OUTPUT);  // Led_Builtin représente la led de l'arduino. 
}

void loop() {
  lm.traduction(mCode, timer);
  lm.space();
  /** Si vous voulez tester une phrase à partir du moniteur série :
     On définit un nouveau char monitChar, qu'on rajoute à notre mCode à traduire.
     Si notre char est equivalent à une nouvelle ligne c'est la fin de notre boucle.
     Et on traduit :
     while (Serial.available()) {
    char monitChar = (char)Serial.read();
    mCode += monitChar;
    if (inChar == '\n') {
      Serial.println(mCode);
      toDo();
    }
    }*/
}
