Oumniaa/BHIKIRprojet_robot_pompier/code/main/CapteurLaser.ino

#include "Adafruit_VL53L0X.h"


// objects for the vl53l0x
Adafruit_VL53L0X lox1 = Adafruit_VL53L0X();
Adafruit_VL53L0X lox2 = Adafruit_VL53L0X();

// this holds the measurement
VL53L0X_RangingMeasurementData_t measure1;
VL53L0X_RangingMeasurementData_t measure2;

CapteurLaser::CapteurLaser(){
}


void CapteurLaser::capturerDistanceLaser(){
  lox1.rangingTest(&measure1, false); // pass in 'true' to get debug data printout!
  lox2.rangingTest(&measure2, false); // pass in 'true' to get debug data printout!
}

int CapteurLaser::get_mesure_cap_1(){
  return (int)measure1.RangeMilliMeter/10;
}


int CapteurLaser::get_mesure_cap_2(){
  return (int)measure2.RangeMilliMeter/10;
}

void setID() {
  // all reset
  digitalWrite(SHT_LOX1, LOW);    
  digitalWrite(SHT_LOX2, LOW);
  delay(20);
  
  // all unreset
  digitalWrite(SHT_LOX1, HIGH);
  digitalWrite(SHT_LOX2, HIGH);
  delay(20);

  // activating LOX1 and resetting LOX2
  digitalWrite(SHT_LOX1, HIGH);
  digitalWrite(SHT_LOX2, LOW);
  
  // initing LOX1
  if(!lox1.begin(LOX1_ADDRESS)) {
    Serial.println(F("Failed to boot first VL53L0X"));
    while(1);
  }
  delay(20);

  // activating LOX2
  digitalWrite(SHT_LOX2, HIGH);
  delay(20);

  //initing LOX2
  if(!lox2.begin(LOX2_ADDRESS)) {
    Serial.println(F("Failed to boot second VL53L0X"));
    while(1);
  }
}
