Oumniaa/BHIKIRprojet_robot_pompier/code/main/CapteurLaser.h

#ifndef H_CapteurLaser
#define H_CapteurLaser


class CapteurLaser
{
  private :

  public :
   CapteurLaser();
   void capturerDistanceLaser();
   int get_mesure_cap_1();
   int get_mesure_cap_2();
};

#endif 
