Oumniaa/BHIKIRprojet_robot_pompier/(commit log)

2022-11-14 Create Boitier arduino
2022-11-15 fichier RIO conception
    [boiteCarteArduinoRIO.3mf]
2022-11-15 création de la classe caméraPosition
2022-11-15 fichier f3d
    [boiteCarteArduinoRIO.f3d]
2022-11-16 TD2 arduino
2022-12-06 capteur laser
2023-01-27 jetson nano
2023-03-11 vision + uart
2023-03-16 reorganisation des dossiers
2023-05-07 rapport sceance + code jetson
